Hampterz/novacode/images/IMG_8082.jpg

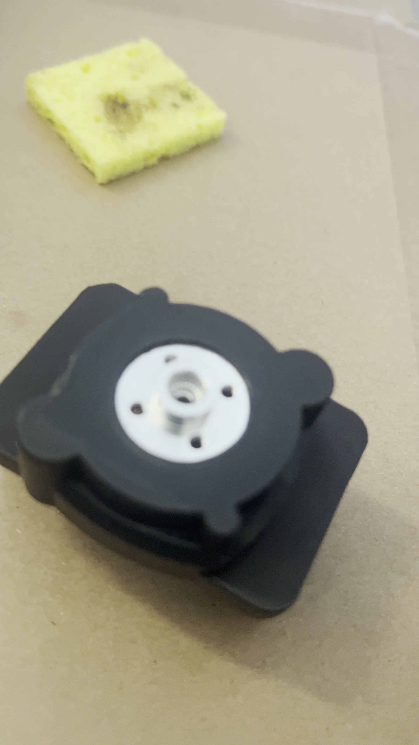
images/IMG_8082.jpg
