Hampterz/novacode/Nova-SM3/STL Files/completed/SM3_Frame_FrontShoulderOuter.stl

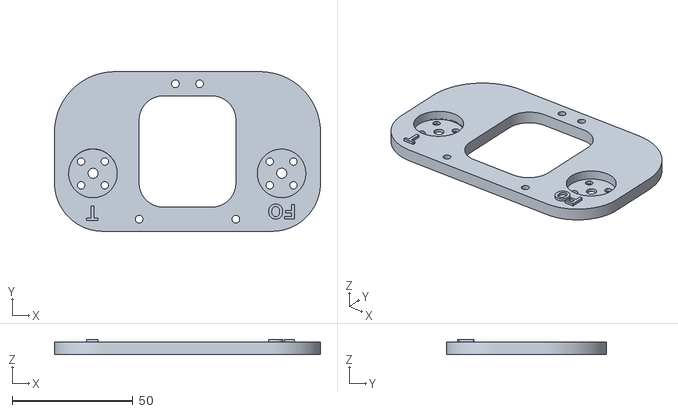
[picture p19: CAD file, 2026-09-12]
Nova-SM3/STL Files/completed/SM3_Frame_FrontShoulderOuter.stl
110.0 x 66.0 x 6.00
