Hampterz/novacode/Nova-SM3/STL Files/completed/SM3_Cover_TopFront.stl

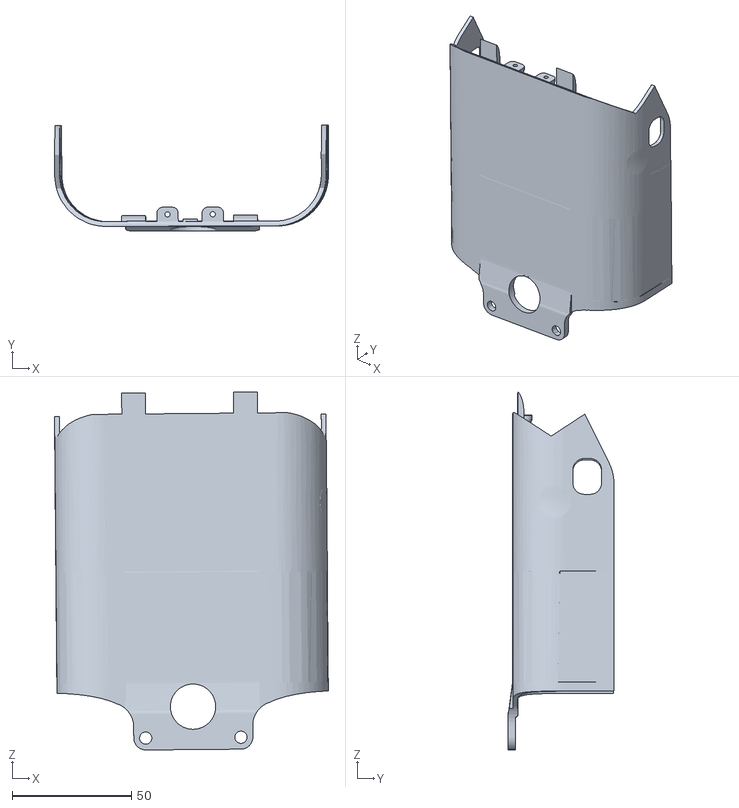
[picture p20: CAD file, 2026-09-12]
Nova-SM3/STL Files/completed/SM3_Cover_TopFront.stl
115.1 x 44.6 x 150.3
