Hampterz/novacode/Nova-SM3/STL Files/completed/SM3_Frame_FrontShoulderMiddle.stl

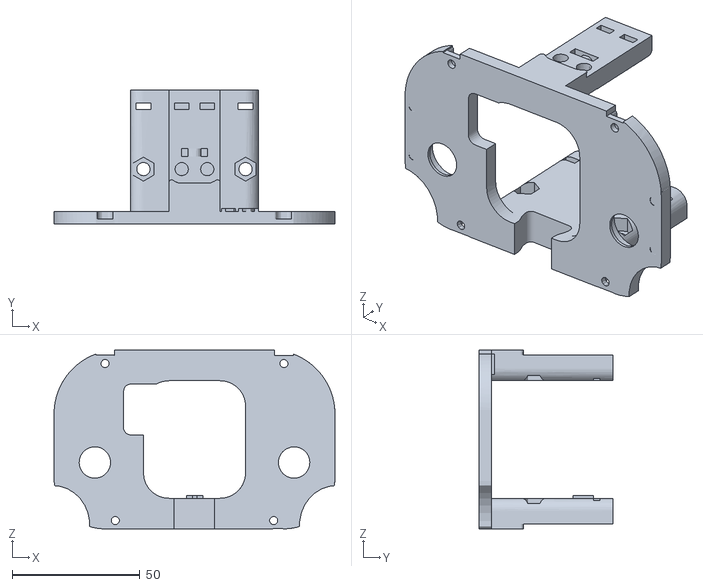
[picture p21: CAD file, 2026-09-12]
Nova-SM3/STL Files/completed/SM3_Frame_FrontShoulderMiddle.stl
110.0 x 52.5 x 70.0
