Hampterz/novacode/Nova-SM3/STL Files/completed/SM3_Cover_BottomRear.stl

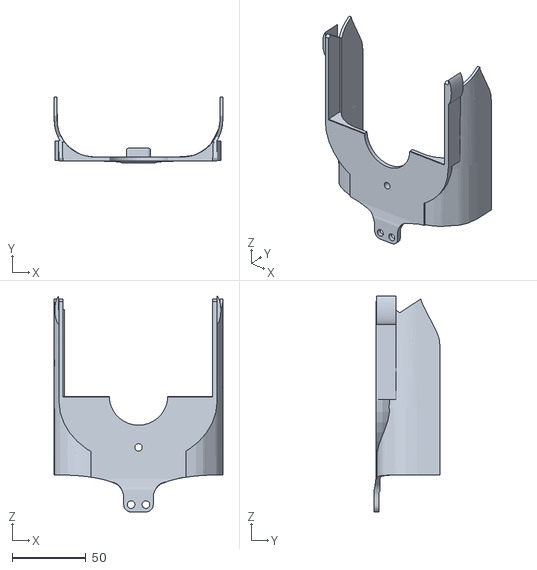
[picture p22: CAD file, 2026-09-12]
Nova-SM3/STL Files/completed/SM3_Cover_BottomRear.stl
114.0 x 44.4 x 146.1
