Hampterz/novacode/Nova-SM3/STL Files/completed/SM3_Cover_RearPanel_2Piece_Shell.stl

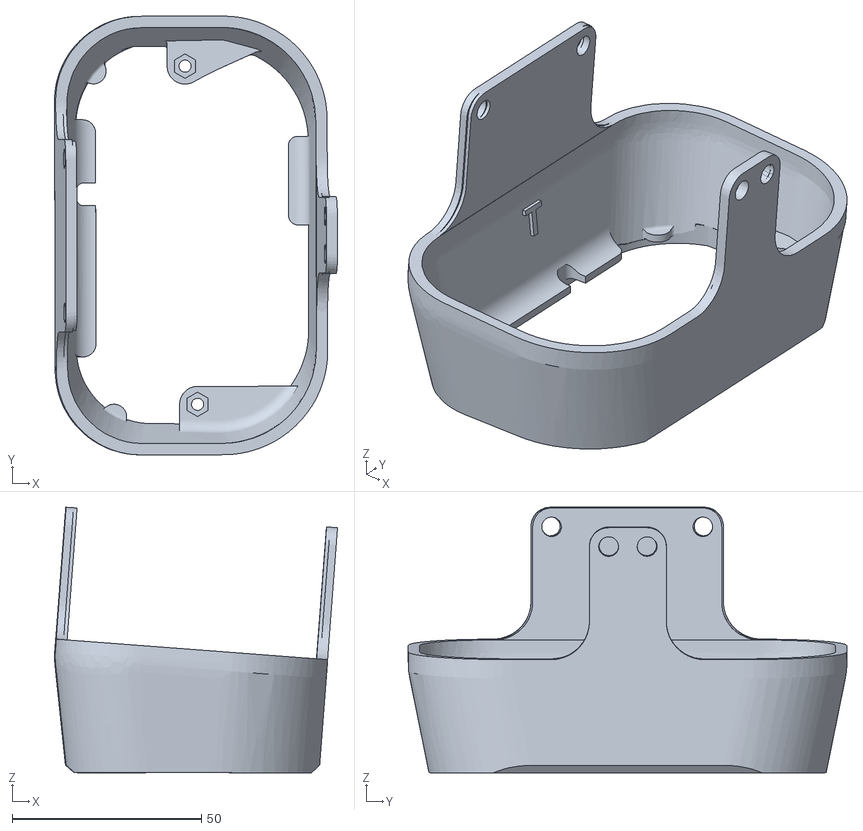
[picture p23: CAD file, 2026-09-12]
Nova-SM3/STL Files/completed/SM3_Cover_RearPanel_2Piece_Shell.stl
74.8 x 116.1 x 70.2
