Hampterz/novacode/Nova-SM3/STL Files/completed/SM3_CalibrationTool.stl

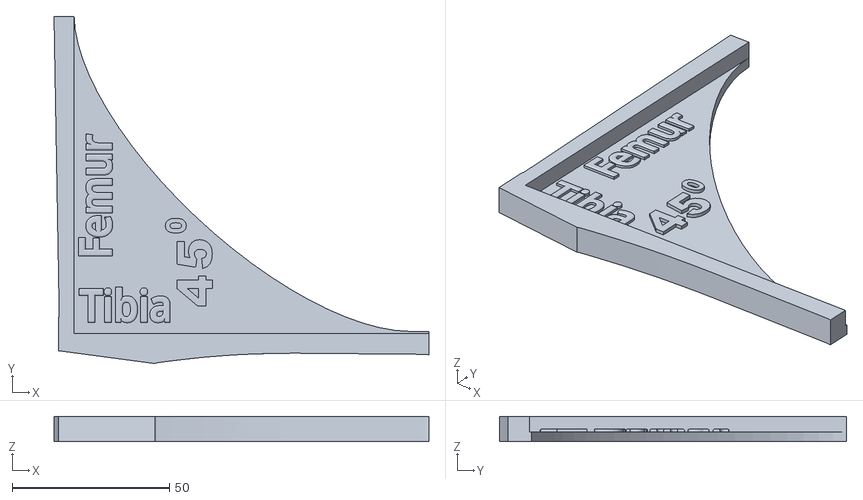
[picture p24: CAD file, 2026-09-12]
Nova-SM3/STL Files/completed/SM3_CalibrationTool.stl
119.4 x 110.6 x 8.00
