Hampterz/novacode/Nova-SM3/STL Files/completed/SM3_Frame_RearShoulderInner.stl

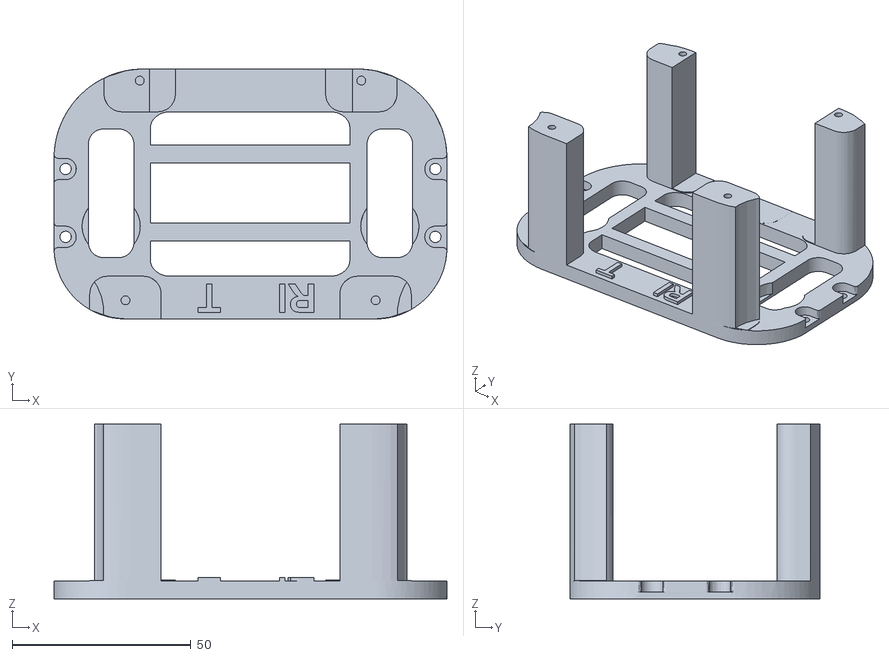
[picture p25: CAD file, 2026-09-12]
Nova-SM3/STL Files/completed/SM3_Frame_RearShoulderInner.stl
110.0 x 70.0 x 49.0
