Hampterz/novacode/Nova-SM3/STL Files/completed/SM3_Cover_RightFemur.stl

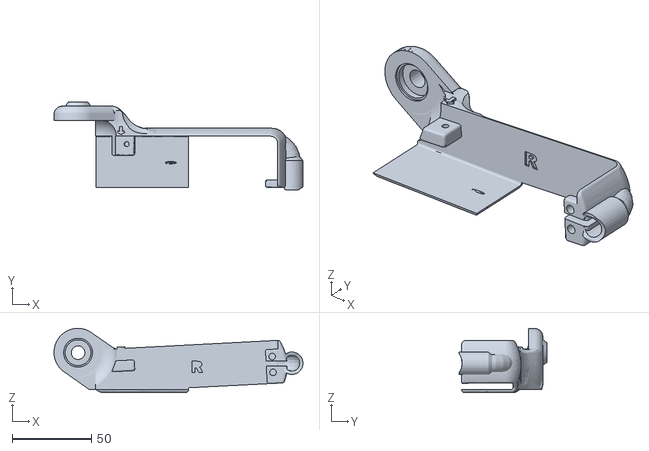
[picture p26: CAD file, 2026-09-12]
Nova-SM3/STL Files/completed/SM3_Cover_RightFemur.stl
156.8 x 55.5 x 40.4
