Hampterz/novacode/Nova-SM3/STL Files/completed/SM3_Foot.stl

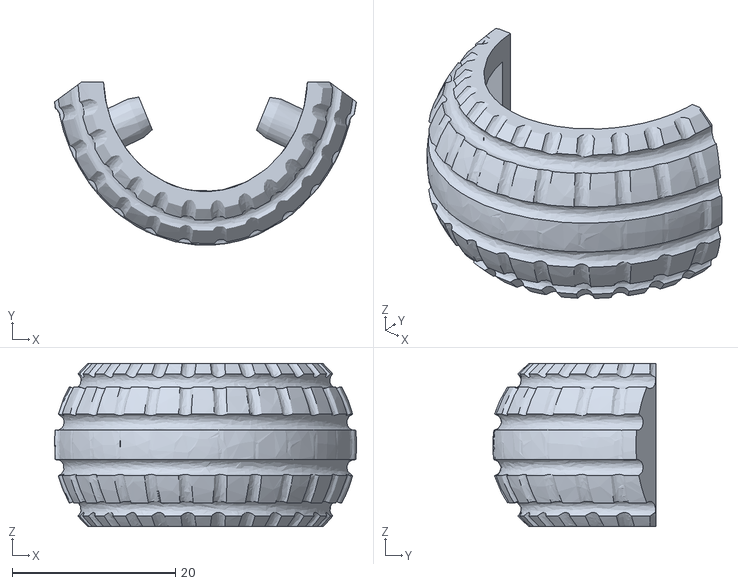
[picture p27: CAD file, 2026-09-12]
Nova-SM3/STL Files/completed/SM3_Foot.stl
37.0 x 20.0 x 20.0
