Hampterz/novacode/Nova-SM3/STL Files/completed/SM3_Frame_ChassisTrunk.stl

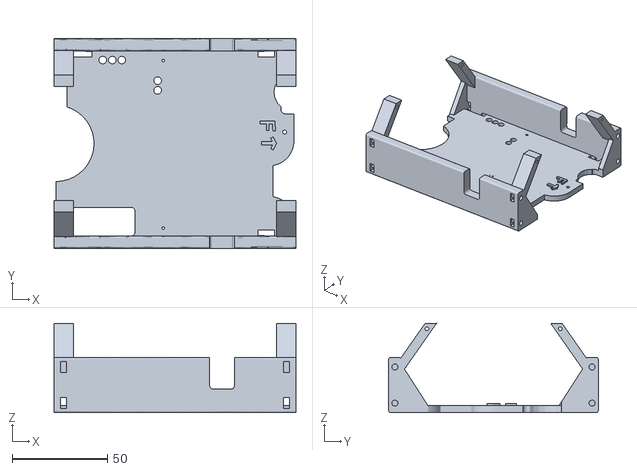
[picture p28: CAD file, 2026-09-12]
Nova-SM3/STL Files/completed/SM3_Frame_ChassisTrunk.stl
127.0 x 110.0 x 46.9
