Hampterz/novacode/Nova-SM3/STL Files/completed/SM3_Cover_BottomHatch.stl

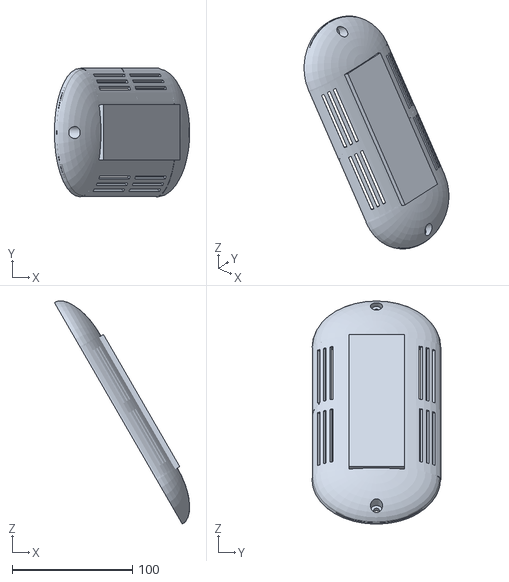
[picture p29: CAD file, 2026-09-12]
Nova-SM3/STL Files/completed/SM3_Cover_BottomHatch.stl
112.5 x 107.4 x 185.6
