Hampterz/novacode/Nova-SM3/STL Files/completed/SM3_Frame_RearShoulderMiddle.stl

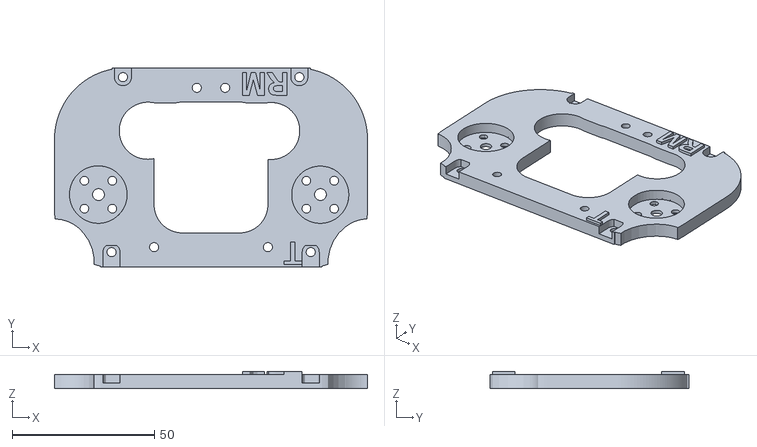
[picture p30: CAD file, 2026-09-12]
Nova-SM3/STL Files/completed/SM3_Frame_RearShoulderMiddle.stl
110.0 x 70.0 x 6.00
