Hampterz/novacode/Nova-SM3/STL Files/completed/SM3_Sensor_FrontPIRMount.stl

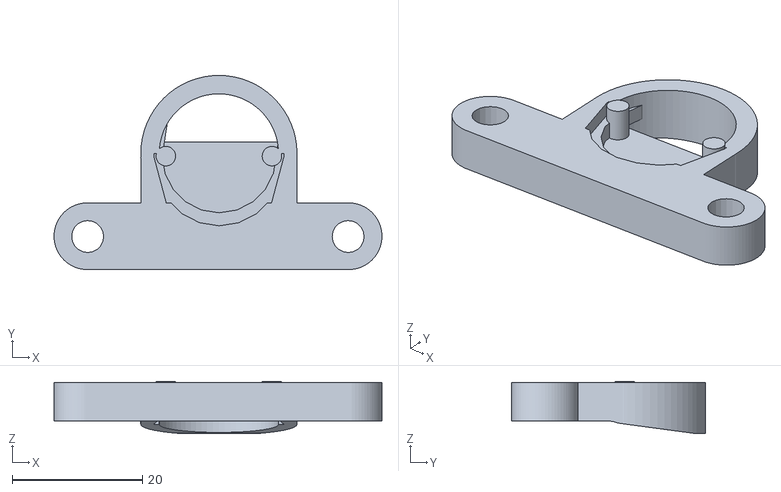
[picture p31: CAD file, 2026-09-12]
Nova-SM3/STL Files/completed/SM3_Sensor_FrontPIRMount.stl
50.4 x 29.8 x 8.05
