Hampterz/novacode/Nova-SM3/STL Files/completed/SM3_Cover_RearPanel_2Piece_Base.stl

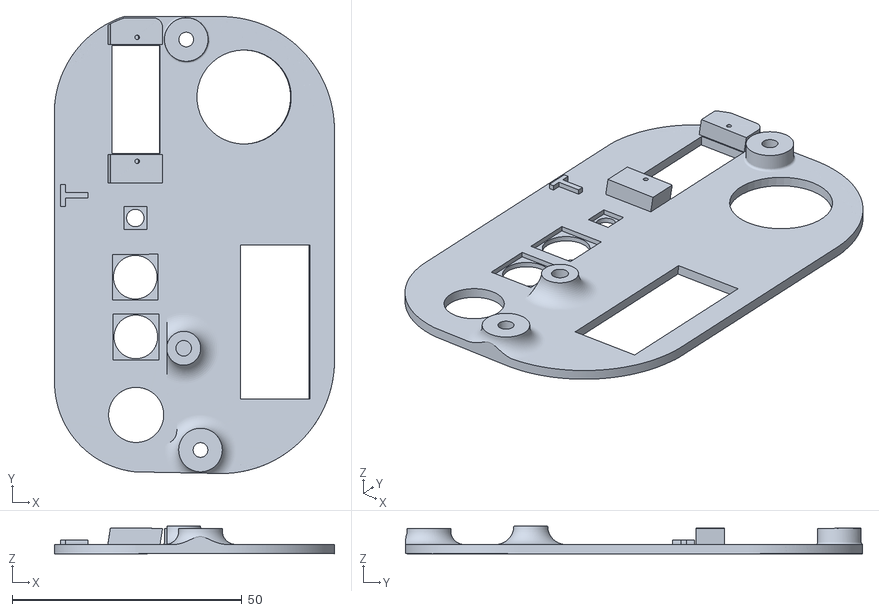
[picture p32: CAD file, 2026-09-12]
Nova-SM3/STL Files/completed/SM3_Cover_RearPanel_2Piece_Base.stl
61.0 x 99.6 x 6.04
