Hampterz/novacode/Nova-SM3/STL Files/completed/SM3_Cover_RearPanelBtnHolder_6x6LongBtn.stl

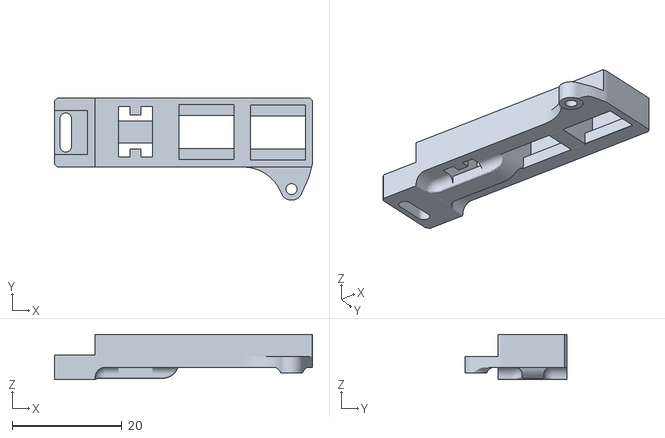
[picture p33: CAD file, 2026-09-12]
Nova-SM3/STL Files/completed/SM3_Cover_RearPanelBtnHolder_6x6LongBtn.stl
46.9 x 18.6 x 8.23
