Hampterz/novacode/Nova-SM3/STL Files/completed/SM3_Cover_TopRear.stl

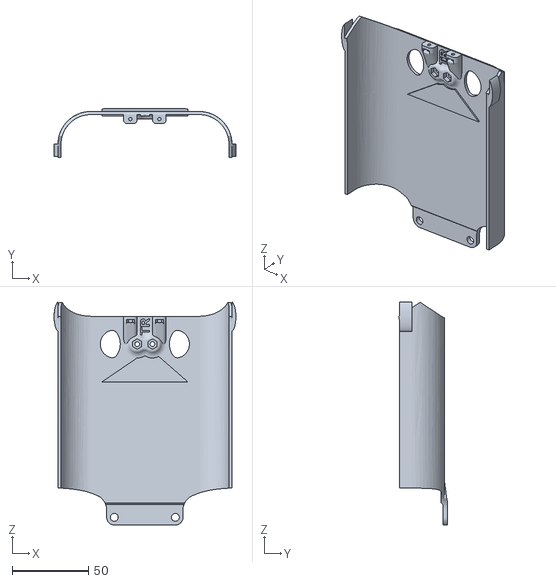
[picture p34: CAD file, 2026-09-12]
Nova-SM3/STL Files/completed/SM3_Cover_TopRear.stl
119.1 x 32.1 x 146.0
