Hampterz/novacode/Nova-SM3/STL Files/completed/SM3_Sensor_RearPIRMount.stl

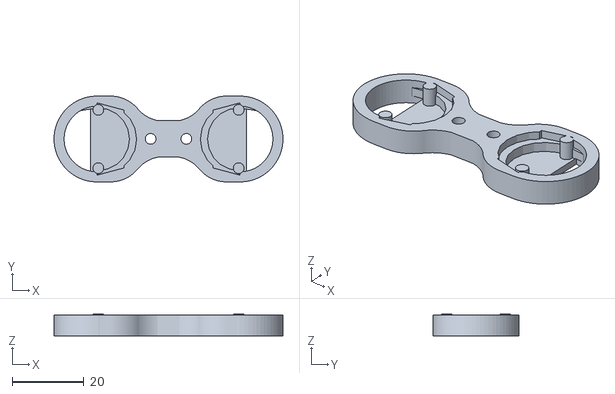
[picture p35: CAD file, 2026-09-12]
Nova-SM3/STL Files/completed/SM3_Sensor_RearPIRMount.stl
64.0 x 24.1 x 6.10
