Hampterz/novacode/Nova-SM3/STL Files/completed/SM3_Frame_LeftCoax.stl

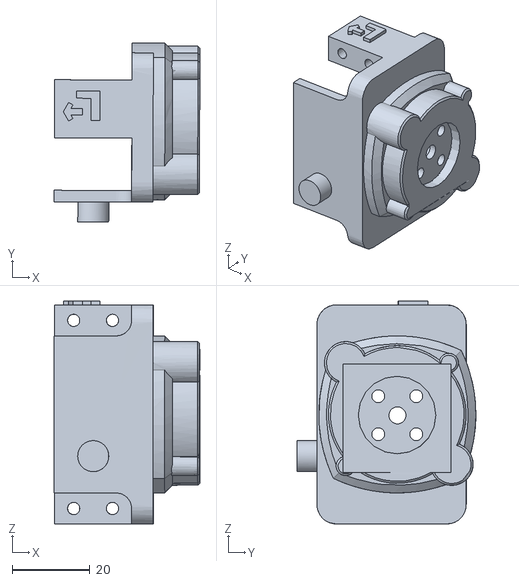
[picture p36: CAD file, 2026-09-12]
Nova-SM3/STL Files/completed/SM3_Frame_LeftCoax.stl
37.6 x 46.1 x 57.5
