Hampterz/novacode/Nova-SM3/STL Files/completed/SM3_Frame_LeftFemur.stl

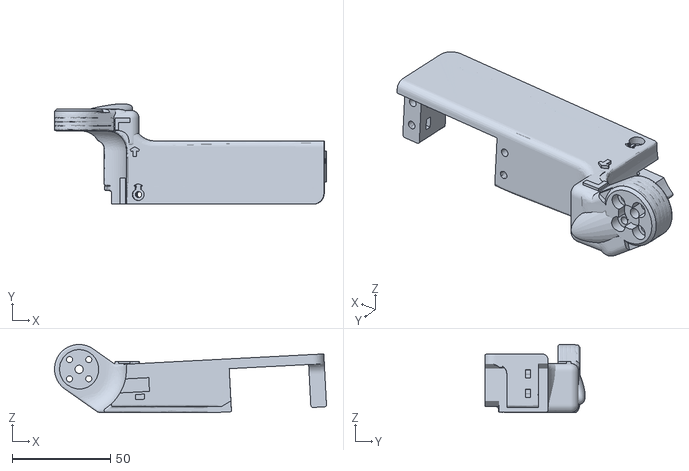
[picture p37: CAD file, 2026-09-12]
Nova-SM3/STL Files/completed/SM3_Frame_LeftFemur.stl
138.5 x 51.1 x 34.7
