Hampterz/novacode/Nova-SM3/STL Files/completed/SM3_Frame_RightTibia.stl

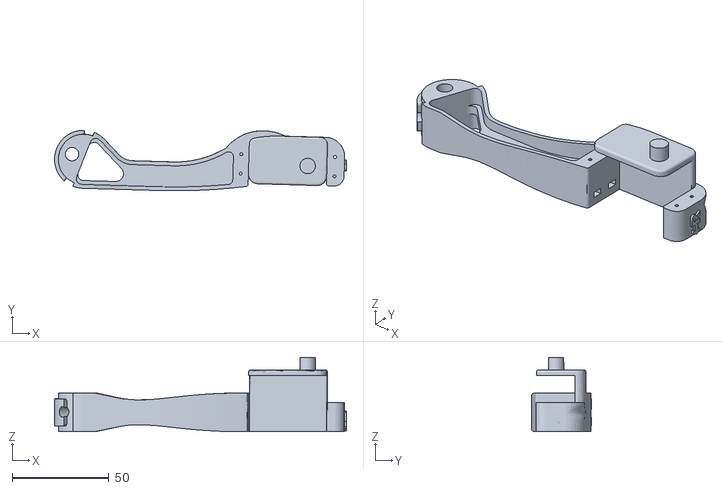
[picture p38: CAD file, 2026-09-12]
Nova-SM3/STL Files/completed/SM3_Frame_RightTibia.stl
151.0 x 31.3 x 38.5
