Hampterz/novacode/Nova-SM3/STL Files/completed/SM3_Cover_HeadPanel.stl

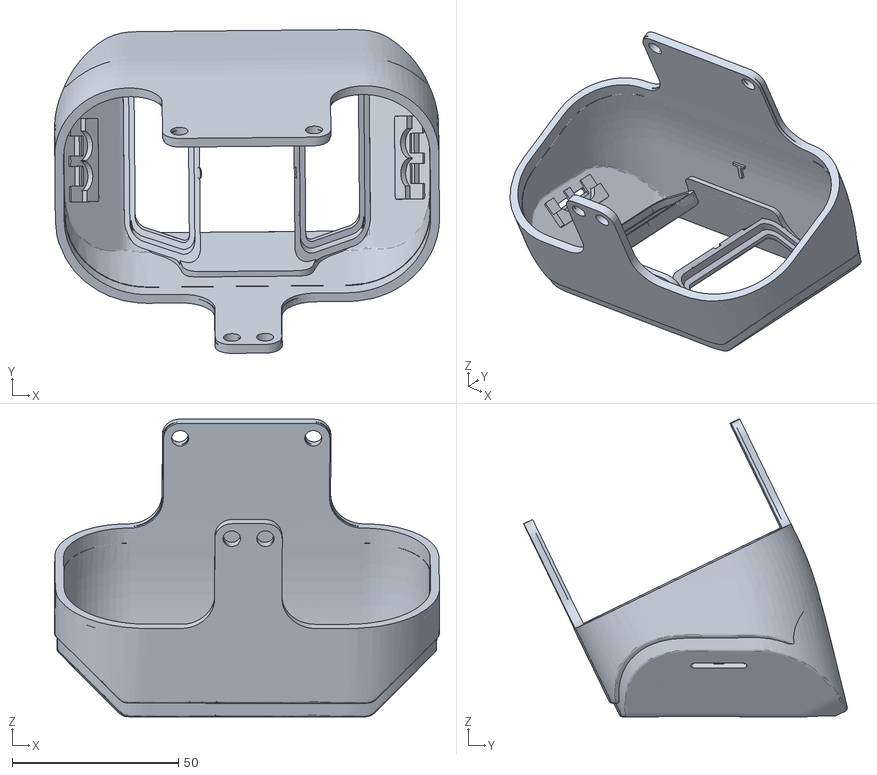
[picture p39: CAD file, 2026-09-12]
Nova-SM3/STL Files/completed/SM3_Cover_HeadPanel.stl
115.7 x 97.3 x 89.5
