Hampterz/novacode/Nova-SM3/STL Files/completed/SM3_Frame_LeftTibia.stl

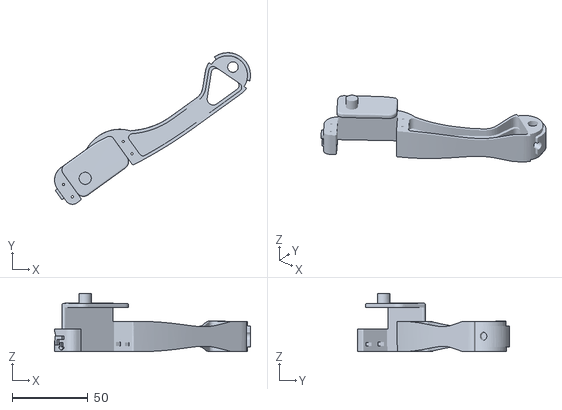
[picture p40: CAD file, 2026-09-12]
Nova-SM3/STL Files/completed/SM3_Frame_LeftTibia.stl
129.3 x 100.1 x 38.5
