Hampterz/novacode/Nova-SM3/STL Files/completed/SM3_Sensor_MP3SpeakerMount.stl

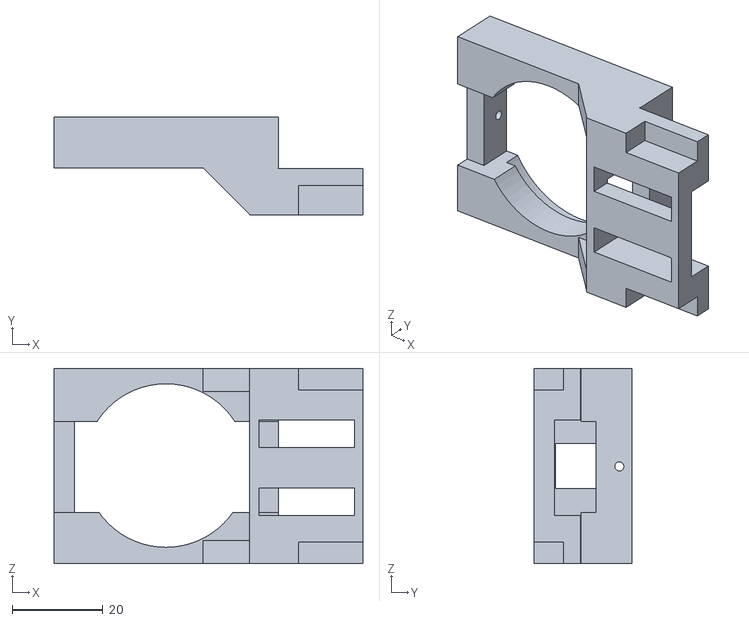
[picture p41: CAD file, 2026-09-12]
Nova-SM3/STL Files/completed/SM3_Sensor_MP3SpeakerMount.stl
68.0 x 21.6 x 43.0
