Hampterz/novacode/Nova-SM3/STL Files/completed/SM3_Cover_BottomFront.stl

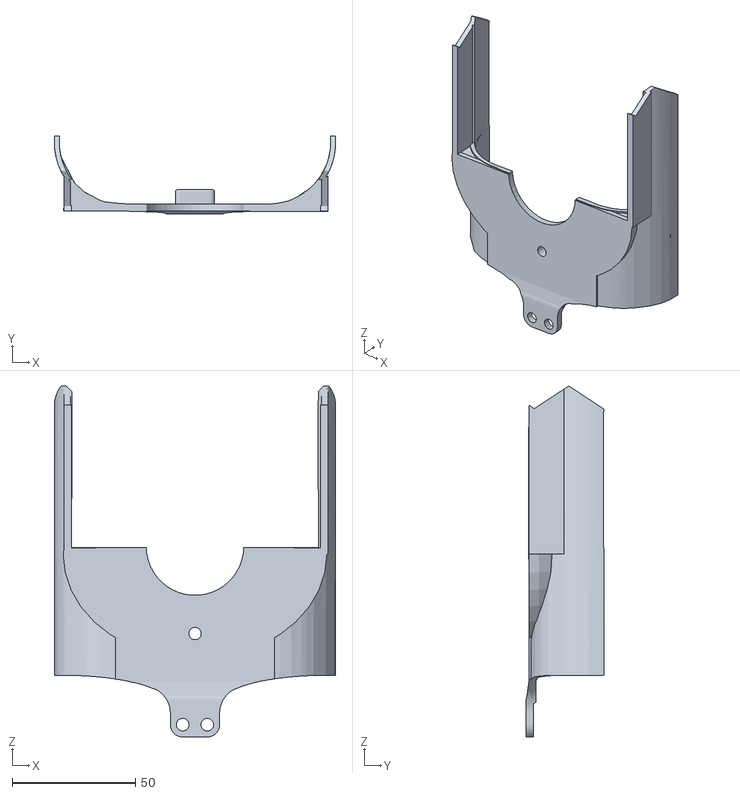
[picture p42: CAD file, 2026-09-12]
Nova-SM3/STL Files/completed/SM3_Cover_BottomFront.stl
114.0 x 31.6 x 142.3
