Hampterz/novacode/Nova-SM3/STL Files/completed/SM3_Sensor_PIRCup.stl

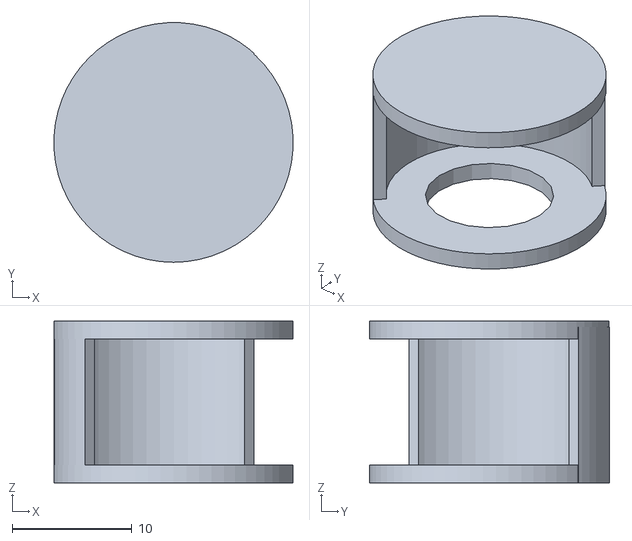
[picture p43: CAD file, 2026-09-12]
Nova-SM3/STL Files/completed/SM3_Sensor_PIRCup.stl
20.0 x 20.0 x 13.5
