Hampterz/novacode/Nova-SM3/STL Files/completed/SM3_Electronics_BuckConveterCase.stl

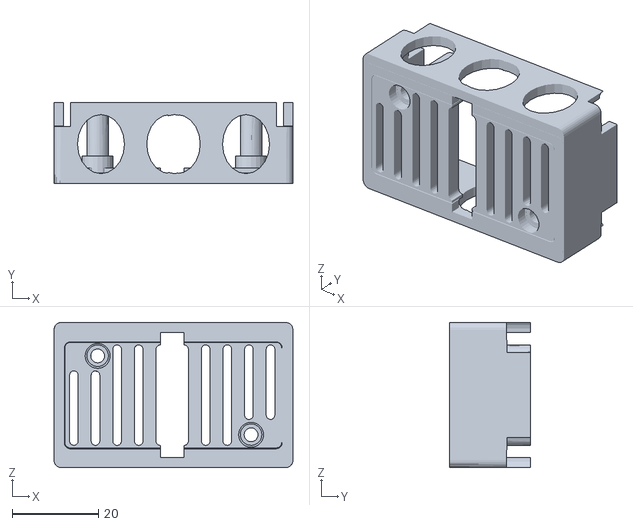
[picture p44: CAD file, 2026-09-12]
Nova-SM3/STL Files/completed/SM3_Electronics_BuckConveterCase.stl
55.3 x 18.8 x 33.6
