Hampterz/novacode/Nova-SM3/STL Files/completed/SM3_Mp3ProSpeakerMount.stl

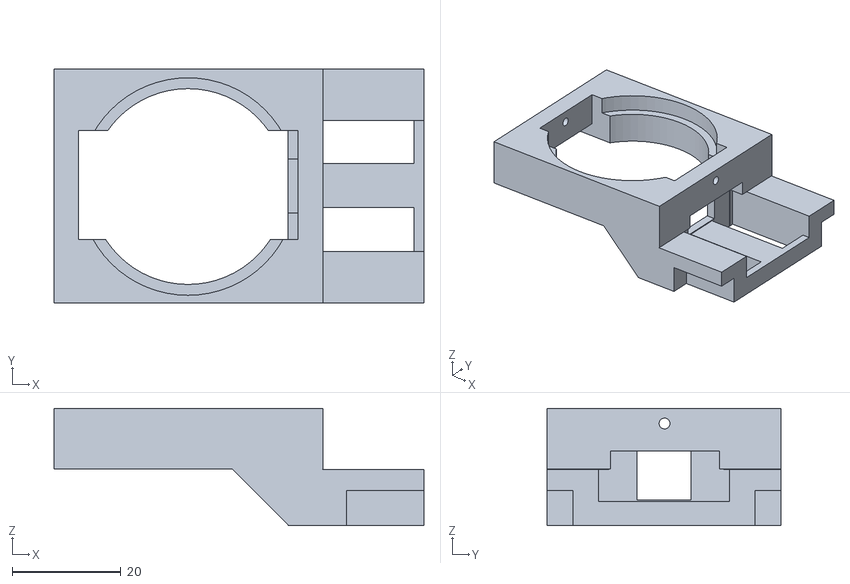
[picture p45: CAD file, 2026-09-12]
Nova-SM3/STL Files/completed/SM3_Mp3ProSpeakerMount.stl
68.0 x 43.0 x 21.6
