Hampterz/novacode/Nova-SM3/STL Files/completed/SM3_Frame_FrontShoulderInner.stl

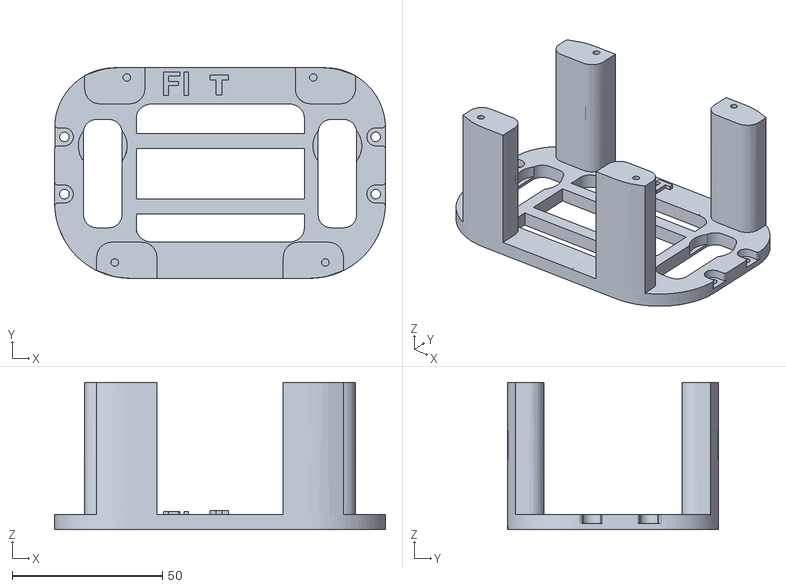
[picture p46: CAD file, 2026-09-12]
Nova-SM3/STL Files/completed/SM3_Frame_FrontShoulderInner.stl
110.0 x 70.0 x 49.0
