Hampterz/novacode/(list of files, cad)

Other CAD files:
Nova-SM3/STL Files/completed/SM3_Cover_LeftFemur.stl
Nova-SM3/STL Files/completed/SM3_Frame_RearShoulderOuter.stl
Nova-SM3/STL Files/completed/SM3_Frame_RightFemur.stl
Nova-SM3/STL Files/completed/SM3_Frame_RightCoax.stl
