Hampterz/novacode/Nova-SM3/Code/Nova-SM3_teensyNRF-v5.2b_mp3_pro/Nova-SM3_teensyNRF-v5.2b_mp3_pro.ino

/*
 * 
 *   NovaSM3 - a Spot-Mini Micro clone
 *   Version: 5.2b
 *   Version Date: 2026-09-13 (turn-in-place semi-success: right turn good, left turn pivots/strains RF; updated home calibration)
 *   
 *   Author:  Chris Locke - cguweb@gmail.com
 *   Nova's website:  https://novaspotmicro.com
 *   GitHub Project:  https://github.com/cguweb-com/Arduino-Projects/tree/main/Nova-SM3
 *   YouTube Playlist:  https://www.youtube.com/watch?v=00PkTcGWPvo&list=PLcOZNHwM_I2a3YZKf8FtUjJneKGXCfduk
 *   
 *   DEBUG NOTE: Teensy will not run if disconnected from serial with any d ebug flag set, as these all
 *               write to serial. Be sure to set all debug flags to 0 before running offline.
 *   
 *   RELEASE NOTES:
 *      Teensy 4.0 performance: 6% storage / 29% memory
 *      Added NRF Module and interface to NovaSMRemote
 *      Removed PS2 setup and interface
 *      Added DFPlayer Mini Pro as second option of MP3 player
 *      Fixed volume pot
 *      Activated code for volume control of MP3 player if enabled
 *      Fixed voltage divider / battery monitor equation
 *      Removed piezo buzzer and TONE support
 *      Added MP3_PLAYER_TYPE setting for DFPlayer Mini and Mini Pro selection
 *
 *
 *   DEV NOTES:
 *      teensy mpu / code is not playing as nicely as with mega - not smooth movement! :(
 *      work on integrating MPU data into movements
 *      adjust sensitivity of PIR (seems 12-24 inches too close)
 *      
 *      BUG: ramping: on interruption of ramp, servo speed is set to the speed of the point of interrupt
 *      
 *      
 *      see more 'DEV NOTE' comments in code for other bugs/tasks
 *      all 'DEV WORK' comments denote code that is currently under development and will be removed upon completion
 *     
 *   =============================================================
 *     
 *   Copyright (c) 2020-2021 Christopher M. Locke and others
 *   Distributed under the terms of the MIT License. 
 *   SPDX-License-Identifier: MIT
 *   
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
 *      
*/

//DEVWORK
int  test_loops = 0;  
int  test_steps = 0;  

//set Nova SM3 version
#define VERSION 5.2

//debug vars for displaying operation runtime data for debugging
const byte debug  = 1;            //general messages
const byte debug1 = 1;            //remote commands and pir sensors
const byte debug2 = 0;            //debug servo steps
const byte debug3 = 0;            //ramping and sequencing
const byte debug4 = 0;            //amperage and battery 
const byte debug5 = 0;            //mpu
const byte debug6 = 0;            //serial communication output/response and serial terminal commands
const byte debug7 = 0;            //uss sensors
const byte debug8 = 0;            //NRF24 comm
const byte plotter = 0;           //plot servo steps, turn off debug1

byte debug_leg = 0;               //default debug leg (3 servos) (changed by serial command input)
int debug_servo = 2;              //default debug servo (changed by serial command input)
int debug_loops = 3;              //default loops for debug movements
int debug_loops2 = 3;             //movement decremented loop
int debug_spd = 10;               //default speed for debug movements

//activate/deactivate devices
byte slave_active = 1;            //activate slave arduino nano (REQUIRED for USS sensors)
byte pwm_active = 1;              //activate pwm controller / servos
byte nrf_active = 1;              //activate NRF24 remote control
byte serial_active = 1;           //activate serial monitor command input
byte mpu_active = 0;              //activate MPU6050 
byte rgb_active = 0;              //activate RGB modules
byte oled_active = 1;             //activate OLED display
byte pir_active = 0;              //activate PIR motion sensor
byte uss_active = 1;              //activate Ultra-Sonic sensors
byte amp_active = 0;              //activate amperate monitoring
byte batt_active = 0;             //activate battery level monitoring
byte buzz_active = 0;             //activate simple tone sounds 
byte melody_active = 0;           //activate melodic tone sounds 
byte mp3_active = 0;              //activate if mp3 player installed
byte splash_active = 0;           //show all loading graphics & sounds
byte quick_boot = 1;              //skip most loading graphics & sounds

#define MP3_PLAYER_TYPE 1         //set to 1 for Mini Pro or to 0 for Mini

//include supporting libraries
#include <Wire.h>
#include <Adafruit_PWMServoDriver.h>
#include <SoftwareSerial.h>
#include <SPI.h>
#include <RF24.h>

//MP3 Setup
//#if MP3_PLAYER_TYPE > 0
  #include <DFRobot_PLAY.h>
  DFRobot_PLAY DFPlayer;
//#else
//  #include <DFRobotDFPlayerMini.h>
//  DFRobotDFPlayerMini DFPlayer;
//#endif


//Teensy 2nd i2c bus and onboard led
#define SDA2_PIN 17
#define SCL2_PIN 16
#define LED_PIN 13

//pwm controller
Adafruit_PWMServoDriver pwm1 = Adafruit_PWMServoDriver(0x40);
#define SERVO_FREQ 60             //CAUTION: do not change this once calibrated to servos!
#define OSCIL_FREQ 25000000       //CAUTION: do not change this once calibrated to servos!
#define OE_PIN 3                  //PWM Output Enable pin
byte pwm_oe = 0;                  //boolean control for enable / disable output
const float min_spd = 32.0;       //min is higher than max, since this is the time increment delay between servo calls 
const float max_spd = 0.0;        //maximum, fastest speed
float default_spd = 2.5;          //fast responsive default speed (was 12.0)
float spd = default_spd;
float spd_prev = default_spd;
float spd_factor = 1.0;           //ratio factor used in movements
const float min_spd_factor = 5.0;
const float max_spd_factor = 0.5;
float spd_c;
float spd_f;
float spd_t;
byte step_start = 0;              //boolean to check if sequenced steps are running
float x_dir = 0;
float y_dir = 0;
float z_dir = 0;
byte use_ramp = 0;                //boolean to enable / disable ramping function
float ramp_dist = 0.20;           //ramp percentage distance from each end of travel (ex: 0.20 ramps up from 0-20% of travel, then ramps down 80-100% of travel)
float ramp_spd = 5.00;            //default ramp speed multiplier

//buzzer
#define BUZZ 22                   //piezo buzzer / speaker module pin

//MP3 DFPlayer 
//track list: 
//  1.saber 2.r2one 3.r2two 4.siren 5.chewy 6.radar 7.mariobro 8.laugh 9.what 10.nova 11.hello
//  12.mode1 13.mode2 14.mode3 15.mode4 16.fon 17.foff 18.sustain 19.warn 20.danger 21.critical 22.halt
//  23.fmodeon 24.fmodeoff 25.click1  
#define MP3_VOL_PIN A9
unsigned int potInterval = 1000;
unsigned long lastPotUpdate = 0;
static const uint8_t PIN_MP3_TX = 1;
static const uint8_t PIN_MP3_RX = 0; 
#define softwareSerial Serial1 // FIX: Teensy 4.0 does not support SoftwareSerial, use hardware Serial1 (pins 0/1)

//mp3 player
unsigned int mp3Interval = 50;
unsigned long lastMP3Update = 0;
int mp3_queue[5] = {0,0,0,0,0};   //DEV: queue of sounds to be played
int mp3_status = 0;               //current playing status
int vpot_max = 350;               //for crappy unreliable pots, set this to your pot's max (-1036)
int vpot_min = 50;                //for crappy unreliable pots, set this to your pot's min (+0)
int vpot_loop = 8;                //for crappy unreliable pots, loop and average value
int vpot_cnt = 0;                 //count of loops for average value
int vpot_avg = 0;                 //total for loop and average value
int vol_max = 25;                 //at mp3 player max of 30, small speakers distort - 25 is suggested
int vol_min = 0;                  //set to 0 to essentially turn off sounds at lowest volume
int sound_vol = 15;               //current volume (1-30)
int sound_volp = 15;              //prev current volume (1-30)
int sounds_req = 25;              //required sound files
int sounds_sd = 0;                //sd card sound files
int sound_cnt = 0;                //loop timer count
int sound_cur = 0;                //current loop timer

//rgb leds
int pattern_int = 250;            //set pattern delay between
int pattern_cnt = 3;              //set number of loops of pattern

//pir sensor
#define PIR_FRONT 4
#define PIR_LEFT 5
#define PIR_RIGHT 6
unsigned int pirInterval = 150;
unsigned long lastPIRUpdate = 0;
unsigned int pirDelay = 3;        //number of interval cycles, not ms
int pir_frontState = LOW;
int pir_leftState = LOW;
int pir_rightState = LOW;
int pir_halt = 1;
byte pir_reset = 0;
int pir_wait = 0;
byte pir_state = LOW;
byte pir_val = 0;
int pir_repeat_cnt = 0;
int pir_is_active = pir_active;
int follow_dir = 0;
int follow_dir_prev = 0;

//ultrasonic sensors (2 - left & right)
unsigned int ussInterval = 250;
unsigned long lastUSSUpdate = 0;
int distance_alarm = 10;              //distance to set triggers
int distance_alarm_set = 0;           //count consecutive set triggers
int distance_tolerance = 5;           //threshold before setting triggers
int distance_l;                       //current distance from left sensor
int prev_distance_l;                  //previous distance of left sensor to prevent false positives
int distance_r;                       //current distance from right sensor
int prev_distance_r;                  //previous distance of right sensor to prevent false positives
int uss_is_active = uss_active;


//mpu6050 sensor
const int MPU = 0x68;
unsigned int mpuInterval = 10;
unsigned int mpuInterval_prev = 400;
unsigned long lastMPUUpdate = 0;
float mroll, mpitch, myaw;
float mroll_prev, mpitch_prev, myaw_prev;
float accAngleX, accAngleY, gyroAngleX, gyroAngleY, gyroAngleZ;
float mpu_mroll = 0.00;
float mpu_mpitch = 0.00;
float mpu_myaw = 0.00;
float mpu_trigger_thresh = 0.05;
float elapsedTime;
unsigned long currentTime, previousTime;
int mpu_is_active = mpu_active;
int mpu_c = 0;

//NovaSMRemote NRF24 controller
//Pin wiring for Teensy 4.0:
//  pin 9 -> CE pin
//  pin 10 -> CSN pin
//  pin 13 -> SCK pin
//  pin 11 -> MOSI pin
//  pin 12 -> MISO pin
//  pin xx -> IRQ pin (unused)
// instantiate an object for the nRF24L01 transceiver
RF24 nrf_radio(9, 10);
unsigned int nrfInterval = 50;
unsigned long lastNRFUpdate = 0;
unsigned int remoteInterval = 50;
unsigned long lastRemoteUpdate = 0;

uint8_t address[][6] = {"1Node", "2Node"};
bool radioNumber = 1; // 0 uses address[0] to transmit, 1 uses address[1] to transmit
const int data_num = 14;          //bytes of data to receive
bool rc_resp;
uint8_t rc_data[data_num] = {     //receive data array
  0, 0, 0, 0,                     //btn1, btn2, btn3, btn4
  0, 0,                           //sel1, sel2
  0, 0, 0, 0,                     //p1, p2, p3, p4
  0, 0, 0, 0                      //lx, ly, rx, ry
};
uint8_t tm_data[data_num] = {     //transmit data array
  0, 0, 0,                        //battery, spd, volume
  0, 0, 0,                        //move_steps, step_weight_factor_front, step_weight_factor_rear
  1, 0, 0, 0,                     //remote_select, start_mode
  0, 0, 0, 0                      //
};
//init remote control vars
uint8_t btn1 = 0, btn2 = 0, btn3 = 0, btn4 = 0;
uint8_t btn1p = 0, btn2p = 0, btn3p = 0, btn4p = 0;
uint8_t sel1 = 0, sel2 = 0; 
uint8_t sel1p = 0, sel2p = 0; 
int pot_threshold = 5;
uint8_t p1t = pot_threshold, p2t = pot_threshold, p3t = pot_threshold, p4t = pot_threshold; 
uint8_t p1 = 0, p2 = 0, p3 = 0, p4 = 0; 
uint8_t p1p = 0, p2p = 0, p3p = 0, p4p = 0; 
uint8_t lx = 0, ly = 0, rx = 0, ry = 0; 
uint8_t lxp = 0, lyp = 0, rxp = 0, ryp = 0; 
int pot_min = 0;                     //if pots are orientated opposing to this configuration, 
int pot_max = 255;                   //swap these two values where min would be max value, and vice-versa
int remote_start_stop = 0;           //tracks remote start/stop mode
int remote_select = 1;               //sets default button set
byte start_mode = 0;                 //current start mode
int spd_lock = 0;                    //switch to hold prev spd and allow code to control spd, and not input device(s)
int step_lock = 0;                   //switch to hold prev steps and allow code to control move_steps, and not input device(s)


//slave arduino and serial commands
#define SLAVE_ID 1
byte serial_oled = 0;            //switch for serial or oled commands
int serial_resp;
int ByteReceived;
unsigned int serialInterval = 60;
unsigned long lastSerialUpdate = 0;
String serial_input;


//amperage monitor
#define AMP_PIN A1
#define PWR_PIN 2
unsigned int ampInterval = 15000;
unsigned long lastAmpUpdate = 0;
int amp_cnt = 0;
int amp_thresh = 10;            //loop count for consecutive amperage alarms to prevent false positives
int amp_warning = 0;            //current alarm warning level
int amp_loop = 1;               //if warning level set, this changes accordingly to prevent false positives
float amp_limit = 6.5;          //aperage draw limit before triggering alarms


//battery monitor
#define BATT_MONITOR A1
unsigned long batteryInterval = 30000;
unsigned long lastBatteryUpdate = 0;
int batt_cnt = 0;
float batt_voltage = 11.8;                          //approx fully charged battery minimum nominal voltage
float batt_voltage_prev = 11.8;                     //comparison voltage to prevent false positives
float avg_volts = 0;
float batt_levels[10] = {                           //voltage drop alarm levels(10)
   11.2, 11.1, 11.0, 10.9, 10.8, 
   10.7, 10.6, 10.5, 10.4, 10.3,
};


//movement vars for steps, delays, loops, sequencing, etc
unsigned long lastMoveDelayUpdate = millis();
unsigned int moveDelayInterval = 0;
int move_delays[16] = {0,0,0,0,0,0,0,0,0,0,0,0,0,0,0,0};
int move_delay_sequences[16] = {0,0,0,0,0,0,0,0,0,0,0,0,0,0,0,0};
int move_delay = 0;
int move_loops = 0;
int move_switch = 0;
float move_steps_min = -100;
float move_steps_max = 100;
float move_steps = 30;
float move_steps_prev = 0;
float move_steps_x = 0;
float move_steps_y = 0;
float move_steps_yaw_x = 0;
float move_steps_yaw_y = 0;
float move_steps_yaw = 0;
float move_steps_kx = 0;
float move_steps_ky = 0;
float move_steps_alt = 0;
int move_c_steps[2] = {-50, 50};
int move_f_steps[2] = {-165, 165};
int move_t_steps[2] = {-120, 120};
int move_x_steps[2] = {-50, 50};
int move_y_steps[2] = {-180, 130};
int move_z_steps[2] = {-50, 50};
float x_dir_steps[2] = {-22, 22};
float y_dir_steps[2] = {-22, 22};
float z_dir_steps[2] = {-40, 40};


//booleans to control / monitor movement routine execution
byte moving = 0;
byte move_y_axis = 0;
byte move_x_axis = 0;
byte move_roll = 0;
byte move_roll_body = 0;
byte move_pitch = 0;
byte move_pitch_body = 0;
byte move_trot = 0;
byte move_forward = 0;
byte move_backward = 0;
byte activeGaitPair = 0;
byte move_left = 0;
byte move_right = 0;
byte move_march = 0;
byte move_wake = 0;
byte move_sequence = 0;
byte move_demo = 0;
byte move_wman = 0;
byte move_funplay = 0;
byte move_look_left = 0;
byte move_look_right = 0;
byte move_roll_x = 0;
byte move_pitch_y = 0;
byte move_kin_x = 0;
byte move_kin_y = 0;
byte move_yaw_x = 0;
byte move_yaw_y = 0;
byte move_yaw = 0;
byte move_servo = 0;
byte move_leg = 0;
byte move_follow = 0;
String move_paused = "";

// Function prototypes
void step_left_right(int lorr, int xdir, int ydir, int zdir = 0);
void fast_home_carpet();

//vars used to compensate for center of gravity / momentum / inertia
float step_weight_factor_front = 1.00;
float step_weight_factor_rear = 1.00;
float step_height_factor = 1.25;    //DEV: not used yet


/*
   -------------------------------------------------------
   Function Prototypes
    :required for functions executed from servo class ( I know, I know, poor OOP design calling functions outside of a class ;p )
   -------------------------------------------------------
*/
void set_ramp(int servo, float sp, float r1_spd, float r1_dist, float r2_spd, float r2_dist);
void amperage_check(int aloop);
void powering_down(void);

//include local class / config files
#include <EEPROM.h>
#include "MPU6050_conf.h"
#include "NovaServos.h"           //include motor setup vars and data arrays
#include "AsyncServo.h"           //include motor class


//instantiate servo objects (s_XXX) with driver reference and servo ID
//coax servo objects
AsyncServo s_RFC(&pwm1, RFC);
AsyncServo s_LFC(&pwm1, LFC);
AsyncServo s_RRC(&pwm1, RRC);
AsyncServo s_LRC(&pwm1, LRC);

//femur servo objects
AsyncServo s_RFF(&pwm1, RFF);
AsyncServo s_LFF(&pwm1, LFF);
AsyncServo s_RRF(&pwm1, RRF);
AsyncServo s_LRF(&pwm1, LRF);

//tibia servo objects
AsyncServo s_RFT(&pwm1, RFT);
AsyncServo s_LFT(&pwm1, LFT);
AsyncServo s_RRT(&pwm1, RRT);
AsyncServo s_LRT(&pwm1, LRT);


void setup() {
  //disable servo outputs immediately to prevent twitching during boot
  pinMode(OE_PIN, OUTPUT);
  digitalWrite(OE_PIN, HIGH);  // HIGH = outputs disabled on PCA9685

  //setup onboard LED
  pinMode(LED_PIN, OUTPUT);
  for (int b = 0; b < 3; b++) {
    digitalWrite(LED_PIN, HIGH);
    delay(150);
    digitalWrite(LED_PIN, LOW);
    delay(150);
  }

  //seed arduino pin A0, otherwise random() functions will not be truely random
  randomSeed(analogRead(0));

  if (debug) {
    Serial.begin(19200);

    //allow serial to connect (wait up to 2 seconds max)
    while (!Serial && millis() < 2000) delay(10);
    Serial.println("hi teensy working");
    delay(500);
    Serial.println(F("\n=============================================="));
    Serial.print(F("NOVA SM3 v"));
    Serial.println(VERSION);
    Serial.println(F("=============================================="));
  }

  //setup 2nd i2c bus
  Wire1.begin();
  Wire1.setTimeout(10); // Prevent I2C from hanging forever if slave disconnects
  Wire1.setSDA(SDA2_PIN);
  Wire1.setSCL(SCL2_PIN);

  if (mp3_active) {
//    #if MP3_PLAYER_TYPE > 0
      softwareSerial.begin(115200);
//    #else
//      softwareSerial.begin(9600);
//    #endif

    if (DFPlayer.begin(softwareSerial)) {
      pinMode(MP3_VOL_PIN, INPUT);
      mp3_volume(sound_vol);

//      #if MP3_PLAYER_TYPE > 0
        DFPlayer.setPlayMode(DFPlayer.SINGLE);
        DFPlayer.setPrompt(false);
        DFPlayer.switchFunction(DFPlayer.MUSIC);
        sounds_sd = DFPlayer.getTotalFile();
//      #else
//        DFPlayer.EQ(DFPLAYER_EQ_ROCK);
//        sounds_sd = DFPlayer.readFileCounts();  
//      #endif
    } else if (debug) {
      Serial.println("Connecting to DFPlayer Mini Pro failed!");
    }
  }

  if (melody_active) {
    if (mp3_active) {
      mp3_volume(16);
      mp3_play(10);
      delay(1500);
      mp3_volume(sound_vol);
      if (rgb_active) {
        rgb_request((char*)"GAk");
      }
      mp3_play(1);
      delay(3000);
      if (!quick_boot) {
        mp3_play(2);
        if (!debug) {
          delay(5000);
        }
      }
    }
  } else if (buzz_active) {
    if (mp3_active) {
      mp3_play(1);
      if (!debug && !quick_boot) {
        delay(3000);
      }
    }
  }

  //show active settings, including delays to prevent IDE reset firing setup functions on upload/connect
  if (debug && !quick_boot) {
    Serial.println(F("Active Settings:"));
    if (slave_active) Serial.println(F("  Slave Circuit"));
    digitalWrite(LED_PIN, HIGH);
    delay(500);
    if (pwm_active) Serial.println(F("  PWM Controller"));
    digitalWrite(LED_PIN, LOW);
    delay(500);
    if (nrf_active) Serial.println(F("  NRF24 Wireless"));
    digitalWrite(LED_PIN, HIGH);
    delay(500);
    if (serial_active) Serial.println(F("  Serial Commands"));
    digitalWrite(LED_PIN, LOW);
    delay(500);
    if (mpu_active) Serial.println(F("  MPU6050 IMU"));
    digitalWrite(LED_PIN, HIGH);
    delay(500);
    if (rgb_active) Serial.println(F("  RGB LEDs"));
    digitalWrite(LED_PIN, LOW);
    delay(500);
    if (oled_active) Serial.println(F("  OLED Display"));
    digitalWrite(LED_PIN, HIGH);
    delay(500);
    if (pir_active) Serial.println(F("  PIR Sensors"));
    digitalWrite(LED_PIN, LOW);
    delay(500);
    if (uss_active) Serial.println(F("  Ultra-Sonic Sensors"));
    digitalWrite(LED_PIN, HIGH);
    delay(250);
    digitalWrite(LED_PIN, LOW);
    delay(250);
    if (amp_active) Serial.println(F("  ACS712 Current Sensor"));
    digitalWrite(LED_PIN, HIGH);
    delay(250);
    digitalWrite(LED_PIN, LOW);
    delay(250);
    if (batt_active) Serial.println(F("  Battery Monitor"));
    digitalWrite(LED_PIN, HIGH);
    delay(250);
    digitalWrite(LED_PIN, LOW);
    delay(250);
    if (buzz_active) Serial.println(F("  Buzzer"));
    digitalWrite(LED_PIN, HIGH);
    delay(250);
    digitalWrite(LED_PIN, LOW);
    delay(250);
    if (melody_active) Serial.println(F("  Melody"));
    digitalWrite(LED_PIN, HIGH);
    delay(250);
    digitalWrite(LED_PIN, LOW);
    delay(250);
    if (mp3_active) {
      Serial.print(F("  MP3 Player: found "));
      Serial.print(sounds_sd);Serial.print(F(" of "));
      Serial.print(sounds_req);Serial.println(F(" sounds required on disk"));
    }
    digitalWrite(LED_PIN, HIGH);
    delay(250);
    digitalWrite(LED_PIN, LOW);
    delay(250);
    if (!splash_active) Serial.println(F("  Skip Splash Screen"));
    digitalWrite(LED_PIN, HIGH);
    delay(250);
    digitalWrite(LED_PIN, LOW);
    delay(250);
    Serial.println(F("\n==============================================\n"));
  } else {
    if (!quick_boot) {
      for (int b = 0; b < 4; b++) {
        digitalWrite(LED_PIN, HIGH);
        delay(500);
        digitalWrite(LED_PIN, LOW);
        delay(500);
      }
      for (int b = 0; b < 6; b++) {
        digitalWrite(LED_PIN, HIGH);
        delay(250);
        digitalWrite(LED_PIN, LOW);
        delay(250);
      }
    }
  }
  

  if (mp3_active && debug && !quick_boot) {
    Serial.print(F("MP3 Player intializing..."));
    delay(500);
    Serial.println(F("\t\t\tOK"));
  }




  //init pir sensors
  if (pir_active) {
    pinMode(PIR_FRONT, INPUT);
    digitalWrite(PIR_FRONT, HIGH); 
   
    pinMode(PIR_LEFT, INPUT);
    digitalWrite(PIR_LEFT, HIGH); 
  
    pinMode(PIR_RIGHT, INPUT);
    digitalWrite(PIR_RIGHT, HIGH); 
  }

  //init amp power control
  if (amp_active) {
    pinMode(PWR_PIN, OUTPUT);
    digitalWrite(PWR_PIN, LOW);
  }


  if (rgb_active) {
    rgb_request((char*)"MUNUEAn");
  }

  if (oled_active) {
    oled_request((char*)"o");
  }
  if (!quick_boot) {
    if (buzz_active || mp3_active) {
      if (mp3_active) {
        mp3_play(4);
        delay(3000);
        if (!splash_active) {
          delay(2000);
        }
      }
      digitalWrite(LED_PIN, LOW);
    } else {
      for (int b = 3; b > 0; b--) {
        digitalWrite(LED_PIN, HIGH);
        delay(250);
        digitalWrite(LED_PIN, LOW);
        delay(250);
      }
    }
  }

  //(re)boot slave nano
  if (slave_active) {
    if (splash_active && !quick_boot) {
      command_slave((char*)"Z");
    } else {
      command_slave((char*)"Y");
    }
  }

  //init NRF24 wireless
  if (nrf_active) {
    if (!nrf_radio.begin()) {
      if (debug8) Serial.println(F("radio hardware is not responding!!"));
      while (1) {}
    } else {
      nrf_radio.setPALevel(RF24_PA_LOW);
      nrf_radio.setPayloadSize(sizeof(rc_data));
      nrf_radio.setChannel(124);
      nrf_radio.openReadingPipe(1, address[!radioNumber]);
      nrf_radio.enableAckPayload();
      nrf_radio.startListening();
      nrf_radio.writeAckPayload(1, &tm_data, sizeof(tm_data)); // pre-load data
      if (debug8) Serial.println(F("radio hardware is ready and listening!"));
    }
  }
  
  //init pwm controller
  if (pwm_active) {
    if (oled_active) {
      oled_request((char*)"o");
    }

    if (debug) Serial.print(F("PWM Controller intializing..."));
    pwm1.begin();
    pwm1.setOscillatorFrequency(OSCIL_FREQ);
    pwm1.setPWMFreq(SERVO_FREQ);

    delay(500);
    if (!splash_active) {
      delay(3000);
    }

    if (debug) Serial.println(F("\t\t\tOK"));
    if (debug) {
      Serial.print(TOTAL_SERVOS); Serial.print(F(" Servos intializing..."));
    }

    //set default speed factor
    spd_factor = mapfloat(spd, min_spd, max_spd, min_spd_factor, max_spd_factor);

    //enable servo outputs before homing so staged PWM pulses reach the servos
    digitalWrite(OE_PIN, LOW);
    delay(50);

    //initialize servos and populate related data arrays with defaults
    init_home();
    delay(500);
    if (debug) Serial.println(F("\t\t\tOK"));

  if (melody_active) {
    if (mp3_active) {
      if (!quick_boot) {
        for (int s=0;s<15;s++) {
          mp3_volume((sound_vol-s));
          delay(250);
        }
        DFPlayer.pause();
        delay(200);
        if (oled_active) {
          oled_request((char*)"y");
        }
        mp3_volume(16);
        delay(50);
        mp3_play(11);
        if (rgb_active) {
          rgb_request((char*)"Id");
        }
        delay(5000);
        if (rgb_active) {
          rgb_request((char*)"Hi");
        }
        delay(1000);
        if (oled_active) {
          oled_request((char*)"n");
        }
        delay(3000);
      }
      mp3_play(7);
    }
  } else if (buzz_active) {
    if (mp3_active) {
      mp3_play(7);
    }
  }

  if (mp3_active) {
    mp3_volume(sound_vol);
  }
  if (rgb_active) {
    rgb_request((char*)"xEi");
    delay(1000);
  }

  //now enable servo outputs - everything is initialized, positions are loaded
  digitalWrite(OE_PIN, LOW);  // LOW = outputs enabled
  delay(1000);  // give servos time to smoothly reach home positions

  //init mpu6050 on Wire1 (pins 16=SCL1, 17=SDA1)
  Wire1.begin();
  Wire1.setTimeout(10); // Prevent I2C from hanging forever if slave disconnects
  delay(100);

  uint8_t c = readByte(MPU6050_ADDRESS, WHO_AM_I_MPU6050);  // Read WHO_AM_I register for MPU-6050
  if (c == 0x68) {  
    if (debug) Serial.println(F("MPU6050 IMU detected on 0x68. Initializing..."));
    calibrateMPU6050(gyroBias, accelBias); // Calibrate gyro and accelerometers, load biases in bias registers  
    initMPU6050();                         // Wake device from sleep, set sample rate and DLPF
    mpu_is_active = 1;
    if (debug) Serial.println(F("MPU6050 IMU initialized OK"));
  } else {
    mpu_is_active = 0;
    if (debug) {
      Serial.print(F("MPU6050 not detected on Wire1 (WHO_AM_I returned 0x"));
      Serial.print(c, HEX);
      Serial.println(F(")"));
    }
  }
  }

  if (!mpu_active) {
    if (debug) {
      Serial.println(F("\nNova SM3... \t\t\t\tReady!"));
      Serial.println(F("=============================================="));
      if (!plotter && serial_active) {
        Serial.println();
        Serial.println(F("Type a command input or 'h' for help:"));
      }
    }
  }

  if (rgb_active) {
    rgb_request((char*)"xKg");
  }
  if (oled_active) {
    oled_request((char*)"l");
  }
  if (!quick_boot) {
    delay(1000);
  }
  
  // Sync the MPU timer so the first loop doesn't have a massive elapsedTime spike
  currentTime = millis();
}



void loop() {
  update_servos();

/*
   -------------------------------------------------------
   Check for Moves
    :check if any scripted, sequenced, or dynamic moves are active
    :and execute accordingly along with any required variables defined
   -------------------------------------------------------
*/
  if (move_sequence) {
    run_sequence();
  } else if (move_x_axis) {
    x_axis();
  } else if (move_y_axis) {
    y_axis();
  } else if (move_pitch_body) {
    pitch_body();
  } else if (move_pitch) {
    pitch(x_dir);
  } else if (move_roll_body) {
    roll_body();
  } else if (move_roll) {
    roll();
  } else if (move_trot) {
    step_trot(x_dir, y_dir, z_dir);
  } else if (move_forward) {
    step_forward(y_dir, x_dir, z_dir);
  } else if (move_backward) {
    step_backward(y_dir, x_dir, z_dir);
  } else if (move_left) {
    step_left_right(1, x_dir, y_dir, z_dir);
  } else if (move_right) {
    step_left_right(0, x_dir, y_dir, z_dir);
  } else if (move_march) {
    step_march(x_dir, y_dir, z_dir);
  } else if (move_wake) {
    wake();
  } else if (move_wman) {
    ramp_dist = 0.2;
    ramp_spd = 0.5;
    use_ramp = 1;
    wman();
  } else if (move_funplay) {
    funplay();
  } else if (move_look_left) {
    look_left();
  } else if (move_look_right) {
    look_right();
  } else if (move_roll_x) {
    roll_x();
  } else if (move_pitch_y) {
    pitch_y();
  } else if (move_kin_x) {
    move_kx();
  } else if (move_kin_y) {
    move_ky();
  } else if (move_yaw_x) {
    yaw_x();
  } else if (move_yaw_y) {
    yaw_y();
  } else if (move_yaw) {
    yaw();
  } else if (move_servo) {
    move_debug_servo();
  } else if (move_leg) {
    move_debug_leg();
  }

/*
   -------------------------------------------------------
   Check State Machines
    :check active state machine(s) for execution time by its respective interval
   -------------------------------------------------------
*/
  if (moveDelayInterval && millis() - lastMoveDelayUpdate > moveDelayInterval) {
    delay_sequences();
  }

  if (nrf_active) {
    if (millis() - lastRemoteUpdate > remoteInterval) {
      remote_check();
    }
  }

  if (serial_active) {
    if (millis() - lastSerialUpdate > serialInterval) serial_check();
  }

  if (pir_active) {
    if (millis() - lastPIRUpdate > pirInterval) pir_check();
  }

  if (mpu_active) {
    if(millis() - lastMPUUpdate > mpuInterval) get_mpu();
  }

  if (uss_active) {
    if (millis() - lastUSSUpdate > ussInterval) uss_check();
  }

  if (amp_active) {
    if (ampInterval && millis() - lastAmpUpdate > ampInterval) amperage_check(amp_loop);
  }

  if (batt_active) {
    if(millis() - lastBatteryUpdate > batteryInterval) battery_check(0);
  }

  if (mp3_active && mp3_status) {
    if(millis() - lastMP3Update > mp3Interval) check_mp3();
  }
  if (potInterval && millis() - lastPotUpdate > potInterval) mp3_volume(-1);
}



/*
   -------------------------------------------------------
   Hardware Functions
   -------------------------------------------------------
*/
/*
   -------------------------------------------------------
   Update Servos
    :check if servo(s) need updating
    :this is the core functionality of Nova
   -------------------------------------------------------
*/
void update_servos() {
  //update coxas
  s_RFC.Update();
  s_LFC.Update();
  s_RRC.Update();
  s_LRC.Update();

  //update femurs
  s_RFF.Update();
  s_LFF.Update();
  s_RRF.Update();
  s_LRF.Update();

  //update tibias
  s_RFT.Update();
  s_LFT.Update();
  s_RRT.Update();
  s_LRT.Update();
}


/*
   -------------------------------------------------------
   NRF Check
    :provide general description and explanation here
   -------------------------------------------------------
*/
bool nrf_check() {
  bool resp = false;

  if (nrf_radio.available()) {
    uint8_t bytes = nrf_radio.getDynamicPayloadSize();
    if (bytes > sizeof(rc_data)) {
      // Packet is too large, it's corrupted or invalid.
      // We must read it to clear it from the NRF buffer, but we shouldn't overflow rc_data.
      uint8_t dummy[32];
      nrf_radio.read(&dummy, bytes);
      return false; // discard
    }
    
    nrf_radio.read(&rc_data, bytes);
    
    // Validate packet: buttons and selectors should only ever be 0 or 1.
    // If we receive a packet with random noise that passes the 16-bit CRC (1 in 65536 chance), 
    // it will have random values > 1 for these byte fields.
    // Exception: If it's an image chunk, rc_data[0] == 255.
    if (rc_data[0] != 255) {
      if (rc_data[0] > 1 || rc_data[1] > 1 || rc_data[2] > 1 || rc_data[3] > 1 ||
          rc_data[4] > 1 || rc_data[5] > 1) {
        nrf_radio.flush_rx();
        return false; // Corrupted packet masquerading as valid
      }
    }

    resp = true;

    //send data as acknowledgement
    nrf_ack();

    // Check for Image chunk
    if (rc_data[0] == 255) {
      if (slave_active || oled_active) {
        Wire1.beginTransmission((uint8_t)SLAVE_ID);
        for (int i = 0; i < 14; i++) {
          Wire1.write(rc_data[i]);
        }
        Wire1.endTransmission();
      }
      return true; // Skip normal parsing
    }

    //set remote control vars from nrf received data
    //fire buttons
    btn1 = rc_data[0];
    btn2 = rc_data[1];
    btn3 = rc_data[2];
    btn4 = rc_data[3];

    //sel stop buttons
    sel1 = rc_data[4];
    sel2 = rc_data[5];

    //slide pots
    p1 = rc_data[6];
    p2 = rc_data[7];
    p3 = rc_data[8];
    p4 = rc_data[9];

    //joysticks
    lx = rc_data[10];
    ly = rc_data[11];
    rx = rc_data[12];
    ry = rc_data[13];

    if (debug8) {
      for (int i = 0; i < data_num; i++) {
        Serial.print(rc_data[i]);Serial.print("\t");
      }
      Serial.println(" DATA REC");
    }
    
    // Detailed remote control debug: only print when something interesting arrives
    if (debug1) {
      bool has_action = (sel2 != 0 || p2 != 0 || ry != 127 || lx != 127 || ly != 127 || rx != 127 ||
                         btn1 != 0 || btn2 != 0 || btn3 != 0 || btn4 != 0);
      if (has_action) {
        Serial.print(F("[NRF_RX] sel2=")); Serial.print(sel2);
        Serial.print(F(" p2=")); Serial.print(p2);
        Serial.print(F(" lx=")); Serial.print(lx);
        Serial.print(F(" ly=")); Serial.print(ly);
        Serial.print(F(" rx=")); Serial.print(rx);
        Serial.print(F(" ry=")); Serial.print(ry);
        if (btn1||btn2||btn3||btn4) {
          Serial.print(F(" btn=")); Serial.print(btn1);Serial.print(btn2);Serial.print(btn3);Serial.print(btn4);
        }
        Serial.println();
      }
    }
    lastNRFUpdate = millis();
  }

  return resp;
}


void nrf_ack() {

    //set data
    float bv = (batt_voltage / 2) * 10;
    tm_data[0] = bv;
    tm_data[1] = spd;
    tm_data[2] = sound_vol;
    tm_data[3] = move_steps;
    tm_data[4] = (step_weight_factor_front * 100);
    tm_data[5] = (step_weight_factor_rear * 100);
    tm_data[6] = remote_select;
    tm_data[7] = start_mode;
    tm_data[8] = mpu_active;
    tm_data[9] = constrain(distance_l, 0, 255);   // left USS distance (cm)
    tm_data[10] = constrain(distance_r, 0, 255);  // right USS distance (cm)
    
    if (debug8) {
      for (int i = 0; i < data_num; i++) {
        Serial.print(tm_data[i]);Serial.print("\t");
      }
      Serial.println(" ACK SENT");
    }
    nrf_radio.writeAckPayload(1, &tm_data, sizeof(tm_data)); // load the payload for the next time
}



/*
   -------------------------------------------------------
   Remote Check
    :provide general description and explanation here - too much to comment by line
   -------------------------------------------------------
*/
void remote_check() {

  // NRF disconnect failsafe: if no radio data for 1 second, stop everything
  if (lastNRFUpdate > 0 && (millis() - lastNRFUpdate > 1000)) {
    if (start_mode != 0 || move_march || move_trot || move_follow) {
      if (debug) Serial.println(F("NRF TIMEOUT: Controller disconnected, stopping robot"));
      set_stop_active();
      set_stop();
      move_march = 0;
      move_forward = 0;
      move_backward = 0;
      move_left = 0;
      move_right = 0;
      move_trot = 0;
      move_follow = 0;
      remote_start_stop = 0;
      start_mode = 0;
      y_dir = 0; x_dir = 0; z_dir = 0;
    }
    
    // Auto-recover NRF24L01 if offline for more than 2 seconds (e.g. brownout freeze)
    if (millis() - lastNRFUpdate > 2000) {
      if (debug) Serial.println(F("NRF OFFLINE: Attempting hardware re-init..."));
      nrf_radio.begin();
      nrf_radio.setPALevel(RF24_PA_LOW);
      nrf_radio.setPayloadSize(sizeof(rc_data));
      nrf_radio.setChannel(124);
      nrf_radio.openReadingPipe(1, address[!radioNumber]);
      nrf_radio.enableAckPayload();
      nrf_radio.startListening();
      nrf_radio.writeAckPayload(1, &tm_data, sizeof(tm_data));
      lastNRFUpdate = millis(); // Reset so we wait a full 2s before trying again
    }
    return;
  }

  if (nrf_check()) {

    // ===== Special commands via p2 (always processed, even during demos) =====
    // p2 == 1: Home command
    // p2 == 2: Toggle MPU on/off
    // p2 == 11-15: Direct mode selection (1-5)
    if (p2 >= 1 && p2 != p2p) {
      if (p2 == 1) {
        // HOME: stop everything, smoothly go to home position
        set_stop_active();
        set_stop();
        move_march = 0;
        move_forward = 0;
        move_backward = 0;
        move_left = 0;
        move_right = 0;
        move_trot = 0;
        move_follow = 0;
        remote_start_stop = 0;
        start_mode = 0;
        y_dir = 0; x_dir = 0; z_dir = 0;
        fast_home_carpet();  // fast sequential leg lift homing to relieve carpet tension
        if (debug) Serial.println(F("Remote: HOME (Sequential Carpet Relief)"));
      } else if (p2 == 2) {
        // Toggle MPU
        if (mpu_active) {
          mpu_active = 0;
          set_stay();
          if (debug) Serial.println(F("Remote: MPU OFF"));
        } else {
          if (mpu_is_active) {
            mpu_active = 1;
            mroll = 0.0; mpitch = 0.0; myaw = 0.0;
            mroll_prev = 0.0; mpitch_prev = 0.0;
            gyroAngleX = 0.0; gyroAngleY = 0.0;
            accAngleX = 0.0; accAngleY = 0.0;
            currentTime = millis();
            if (debug) Serial.println(F("Remote: MPU ON"));
          } else {
            if (debug) Serial.println(F("Remote: MPU Hardware Not Detected"));
          }
        }
      } else if (p2 == 3) {
        // SIT
        set_stop_active();
        set_stop();
        move_march = 0; move_forward = 0; move_backward = 0;
        move_left = 0; move_right = 0; move_trot = 0; move_follow = 0;
        remote_start_stop = 0; start_mode = 0;
        y_dir = 0; x_dir = 0; z_dir = 0;
        set_sit();
        if (debug) Serial.println(F("Remote: SIT"));
      } else if (p2 == 4) {
        // LAY DOWN / CROUCH
        set_stop_active();
        set_stop();
        move_march = 0; move_forward = 0; move_backward = 0;
        move_left = 0; move_right = 0; move_trot = 0; move_follow = 0;
        remote_start_stop = 0; start_mode = 0;
        y_dir = 0; x_dir = 0; z_dir = 0;
        set_crouch();
        if (debug) Serial.println(F("Remote: LAY DOWN"));
      } else if (p2 == 5) {
        // Show Custom Image on OLED
        if (oled_active) {
          oled_request((char*)"z");
        }
        if (debug) Serial.println(F("Remote: CUSTOM IMAGE OLED"));
      } else if (p2 >= 11 && p2 <= 15) {
        if (remote_select != p2 - 10) {
          remote_select = p2 - 10;
          remote_start_stop = 0;
          start_mode = 0;
          set_stop_active();
          if (debug) { Serial.print(F("Remote: Direct Mode ")); Serial.println(remote_select); }
        }
      }
      p2p = p2;
    } else if (p2 == 0 && p2p != 0) {
      p2p = 0; // reset previous when key released
    }

    if (!move_demo && !move_funplay) {
/*
Serial.print("here1 : sel1 / sel1p ");
Serial.print(sel1);
Serial.print(" / ");
Serial.print(sel1p);
Serial.print("   sel2 / sel2p ");
Serial.print(sel2);
Serial.print(" / ");
Serial.println(sel2p);
*/      

      //start button by mode
      if (sel2 && sel2 != sel2p) {
        if (!remote_start_stop) {
          remote_start_stop = 1;
          if (debug1)
            Serial.println(F("Start Pressed"));

          if (remote_select == 1) {
            //march
            start_mode = 1;
            if (mp3_active) mp3_play(25);
            if (debug1)
              Serial.println(F("start march"));
            if (!move_march) {
              set_stop();
              y_dir = 0;
              x_dir = 0;
              z_dir = 0;
              if (mpu_is_active) mpu_active = 0;
              move_march = 1;
              if (oled_active) {
                oled_request((char*)"d");
              }
            }
          } else if (remote_select == 2) {
            //walk
            start_mode = 2;
          } else if (remote_select == 3) {
            //freestyle
            start_mode = 3;
          } else if (remote_select == 4) {
            //trot
            start_mode = 4;
            move_trot = 1;
          } else if (remote_select == 5) {
            //follow
            start_mode = 5;
            if (!move_follow) {
              if (debug1)
                Serial.println(F("move follow on"));
              spd_lock = spd;
              spd = 3;
              set_speed();
              move_follow = 1;
              if (mp3_active) {
                mp3_play(23);
                delay(1500);
              }
              if (mpu_is_active) mpu_active = 0;
              if (uss_is_active) uss_active = 0;
            }
          }
        } else {
          remote_start_stop = 0;
          start_mode = 0;
          if (debug1)
            Serial.println(F("Stop Pressed"));
          if (remote_select == 1) {
            if (mp3_active) mp3_play(25);
            if (move_march) {
              if (debug1)
                Serial.println(F("stop march"));
              move_march = 0;
              set_stop();
              y_dir = 0;
              x_dir = 0;
              z_dir = 0;
              if (oled_active) {
                oled_request((char*)"d");
              }
            }
          } else if (remote_select == 2) {
          } else if (remote_select == 3) {
          } else if (remote_select == 4) {
            move_trot = 0;
          } else if (remote_select == 5) {
            if (move_follow) {
              if (debug1)
                Serial.println(F("move follow off"));
              move_follow = 0;
              set_stop();
              if (mp3_active) {
                mp3_play(24);
              }
              if (uss_is_active) uss_active = 1;
            }
          }
          set_stop_active();
        }
      }
      if (sel2 != sel2p) {
        sel2p = sel2;
      }


      //select / set mode button
      if (sel1 && sel1 != sel1p) {
        (remote_select < 5) ? remote_select++ : remote_select = 1;
        if (debug1) {
          Serial.print(F("\tSelected ")); Serial.println(remote_select);
        }
        remote_start_stop = 0;
        start_mode = 0;
        set_stop_active();

        if (rgb_active) {
          if (remote_select == 1) {
            if (mp3_active) mp3_play(12);
            rgb_request((char*)"tEn");
          } else if (remote_select == 2) {
            if (mp3_active) mp3_play(13);
            rgb_request((char*)"uEn");
          } else if (remote_select == 3) {
            if (mp3_active) mp3_play(14);
            rgb_request((char*)"vEn");
          } else if (remote_select == 4) {
            if (mp3_active) mp3_play(15);
            rgb_request((char*)"wEn");
          } else if (remote_select == 5) {
            if (mp3_active) mp3_play(26);
            rgb_request((char*)"xEn");
          }
        }
        if (oled_active) {
          if (remote_select == 1) {
            oled_request((char*)"g");
          } else if (remote_select == 2) {
            oled_request((char*)"h");
          } else if (remote_select == 3) {
            oled_request((char*)"i");
          } else if (remote_select == 4) {
            oled_request((char*)"j");
          } else if (remote_select == 5) {
            oled_request((char*)"x");
          }
        }
      }
      if (sel1 != sel1p) {
        sel1p = sel1;
      }


      //joysticks
      if ((remote_select == 1 && start_mode == 1) || (remote_select == 4 && start_mode == 4)) {

        //gait joysticks for stationary marching
        y_dir = map(ry, 0, 255, y_dir_steps[1], y_dir_steps[0]);
        x_dir = map(lx, 0, 255, x_dir_steps[1], x_dir_steps[0]);
        z_dir = map(ly, 0, 255, z_dir_steps[1], z_dir_steps[0]);

      } else if (remote_select == 2 && start_mode == 2) {

        //gait joysticks for direction marching
        z_dir = map(ly, 0, 255, z_dir_steps[1], z_dir_steps[0]);

        //right y joystick
        y_dir = map(ry, 0, 255, y_dir_steps[1], y_dir_steps[0]);
        if (y_dir > 2) {
          if (!move_forward) {
            if (debug1)
              Serial.println(F("forward"));
            if (mpu_is_active) mpu_active = 0;
            move_march = 1;
            move_forward = 1;
          }
        } else if (y_dir < -2) {
          if (!move_backward) {
            if (debug1)
              Serial.println(F("backward"));
            if (mpu_is_active) mpu_active = 0;
            move_march = 1;
            move_backward = 1;
          }
        } else {
          if (move_forward) {
            move_forward = 0;
            if (debug1)
              Serial.println(F("stop forward"));
          }
          if (move_backward) {
            move_backward = 0;
            if (debug1)
              Serial.println(F("stop backward"));
          }
          if (move_march) {
            move_march = 0;
            if (rgb_active) {
              rgb_request((char*)"OtEn");
            }
          }
        }

        //left x joystick modifier
        x_dir = map(lx, 0, 255, x_dir_steps[1], x_dir_steps[0]);
        if (x_dir > 2) {
          if (!move_right) {
            move_right = 1;
            if (debug1)
              Serial.println(F("move right"));
          }
        } else if (x_dir < -2) {
          if (!move_left) {
            move_left = 1;
            if (debug1)
              Serial.println(F("move left"));
          }
        } else {
          if (move_right) {
            move_right = 0;
            if (debug1)
              Serial.println(F("stop move right"));
          }
          if (move_left) {
            move_left = 0;
            if (debug1)
              Serial.println(F("stop move left"));
          }
          if (!move_forward && !move_backward) {
            set_stop();
          }
        }
      } else if (remote_select == 3 && start_mode == 3) {

        //kinematics joysticks
        if (btn1) {
        } else {
          move_steps_x = map(lx, 0, 255, (move_steps_max / 2), (move_steps_min / 2));
          move_roll_x = 1;
          if (debug1 && move_steps_x) {
            Serial.print(F("move roll_x "));Serial.println(move_steps_x);
          }

          move_steps_y = map(ly, 0, 255, (move_steps_max * 1.4), (move_steps_min * 1.4));
          move_pitch_y = 1;
          if (debug1 && move_steps_y) {
            Serial.print(F("move pitch_y "));Serial.println(move_steps_y);
          }
        }

        if (btn2) {
          //move yaw while button pressed/held
          move_steps_yaw = map(rx, 0, 255, (move_steps_max * 1.4), (move_steps_min * 1.4));
          if (move_steps_yaw > 2 || move_steps_yaw < -2) {
            move_yaw = 1;
            if (debug1)
              Serial.println(F("move yaw"));
          } else {
            move_yaw = 0;
          }

          //move in y while button pressed/held
          move_steps_ky = map(ry, 0, 255, (move_steps_min * 1.4), (move_steps_max * 1.4));
          if (move_steps_ky > 2 || move_steps_ky < -2) {
            move_kin_y = 1;
            if (debug1)
              Serial.println(F("move kin_y"));
          } else {
            move_kin_y = 0;
          }
        } else {
          move_steps_yaw_x = map(rx, 0, 255, (move_steps_max * .5), (move_steps_min * .5));
          if (move_steps_yaw_x > 2 || move_steps_yaw_x < -2) {
            move_yaw_x = 1;
            if (debug1)
              Serial.println(F("move yaw_x"));
          } else {
            move_yaw_x = 0;
          }

          move_steps_yaw_y = map(ry, 0, 255, move_steps_max, move_steps_min);
          if (move_steps_yaw_y > 2 || move_steps_yaw_y < -2) {
            move_yaw_y = 1;
            if (debug1)
              Serial.println(F("move yaw_y"));
          } else {
            move_yaw_y = 0;
          }
        }  
      } else if (remote_select == 5 && start_mode == 5) {
//DEV: unused
      }

      //check fire buttons
      int fired1 = 0;
      if ((btn1 && btn1 != btn1p) && (btn2 && btn2 != btn2p)) {      //press both btn1 and btn2        
          fired1 = 1;
          btn1p = btn1;
          btn2p = btn2;
          if (remote_select == 1 || remote_select == 2 || remote_select == 3 || remote_select == 4 || remote_select == 5) {
            set_stop();
            if (debug1)
              Serial.println(F("stay"));
            if (rgb_active) {
              rgb_request((char*)"Hg");
            }
            set_stay();
            if (oled_active) {
              oled_request((char*)"b");
            }
          }
      }

      int fired2 = 0;
      if ((btn3 && btn3 != btn3p) && (btn4 && btn4 != btn4p)) {      //press both btn3 and btn4        
          fired2 = 1;
          btn3p = btn3;
          btn4p = btn4;
          if (remote_select == 1 || remote_select == 2 || remote_select == 3 || remote_select == 4 || remote_select == 5) {
            set_stop();
            if (rgb_active) {
              rgb_request((char*)"Hg");
            }
            if (debug1)
              Serial.println(F("wake"));
            spd_lock = spd;
            spd = 1;
            set_speed();
            move_loops = 3;
            move_switch = 2;
            move_wake = 1;
          }
      }

      if (!fired1 && !fired2) {
        //btn1
        if (btn1 != btn1p) {                //btn1 pressed
          btn1p = btn1;
          if (btn1) {
            set_stop();
            if (remote_select == 1) {
              ramp_dist = 0.33;
              ramp_spd = 1.5;
              use_ramp = 1;  
            } else if (remote_select == 2) {
              if (!move_roll) {
                move_roll = 1;
                if (debug1)
                  Serial.println(F("move roll"));
              }
            } else if (remote_select == 3) {
//DEV: unused
            } else if (remote_select == 4) {
              set_sit();
              if (rgb_active) 
                rgb_request((char*)"Hi");
              if (debug1)
                Serial.println(F("sit"));
            } else if (remote_select == 5) {
//DEV: unused
            }
          } else {                          //btn1 released
            if (remote_select == 1) {
              use_ramp = 0;
            } else if (remote_select == 2) {
              if (move_roll) {
                move_roll = 0;
                if (debug1)
                  Serial.println(F("stop roll"));
              }
            } else if (remote_select == 3) {
//DEV: unused
            } else if (remote_select == 4) {
//DEV: unused
            } else if (remote_select == 5) {
//DEV: unused
            }
          }
        }  
  
  
        //btn2
        if (btn2 != btn2p) {                //btn2 pressed
          btn2p = btn2;
          if (btn2) {
            set_stop();
            if (remote_select == 1) {
            } else if (remote_select == 2) {
              if (!move_pitch) {
                move_pitch = 1;
                if (debug1)
                  Serial.println(F("move pitch"));
              }
            } else if (remote_select == 3) {
//DEV: unused
            } else if (remote_select == 4) {
              set_kneel();
              if (debug1)
                Serial.println(F("kneel"));
            } else if (remote_select == 5) {
//DEV: unused
            }
          } else {                          //btn2 released
            if (remote_select == 1) {
            } else if (remote_select == 2) {
              if (move_pitch) {
                move_pitch = 0;
                if (debug1)
                  Serial.println(F("stop pitch"));
              }
            } else if (remote_select == 3) {
//DEV: unused
            } else if (remote_select == 4) {
//DEV: unused
            } else if (remote_select == 5) {
//DEV: unused
            }
          }
        }  
  
        //btn3
        if (btn3 != btn3p) {                //btn3 pressed
          btn3p = btn3;
          if (btn3) {
            set_stop();
            if (remote_select == 1) {
            } else if (remote_select == 2) {
              if (!move_roll_body) {
                move_roll_body = 1;
                if (debug1)
                  Serial.println(F("move roll body"));
              }
            } else if (remote_select == 3) {
//DEV: unused
            } else if (remote_select == 4) {
              set_crouch();
              if (rgb_active)
                rgb_request((char*)"Hh");
              if (debug1)
                Serial.println(F("crouch"));
            } else if (remote_select == 5) {
//DEV: unused
            }
          } else {                          //btn3 released
            if (remote_select == 1) {
            } else if (remote_select == 2) {
              if (move_roll_body) {
                move_roll_body = 0;
                if (debug1)
                  Serial.println(F("stop roll body"));
              }
            } else if (remote_select == 3) {
//DEV: unused
            } else if (remote_select == 4) {
//DEV: unused
            } else if (remote_select == 5) {
//DEV: unused
            }
          }
        }  
  
        //btn4
        if (btn4 != btn4p) {                //btn4 pressed
          btn4p = btn4;
          if (btn4) {
            set_stop();
            if (remote_select == 1) {
            } else if (remote_select == 2) {
              if (!move_pitch_body) {
                move_pitch_body = 1;
                if (debug1)
                  Serial.println(F("move pitch body"));
              }
            } else if (remote_select == 3) {
//DEV: unused
            } else if (remote_select == 4) {
              set_lay();
              if (rgb_active)
                rgb_request((char*)"Kd");
              if (debug1)
                Serial.println(F("lay"));
            } else if (remote_select == 5) {
//DEV: unused
            }
          } else {                          //btn4 released
            if (remote_select == 1) {
            } else if (remote_select == 2) {
              if (move_pitch_body) {
                move_pitch_body = 0;
                if (debug1)
                  Serial.println(F("stop pitch body"));
              }
            } else if (remote_select == 3) {
//DEV: unused
            } else if (remote_select == 4) {
//DEV: unused
            } else if (remote_select == 5) {
//DEV: unused
            }
          }
        }  
      }  


/*  
//DEV: these are really just test / demo moves, may not be worth keeping

        //left y joystick
        int my = map(ly, 0, 255, 0, 255);
        if (my > 200) {
          if (!move_trot) {
            set_stop();
            step_lock = 1;
            move_trot = 1;
            if (debug1)
              Serial.println(F("move trot"));
            x_dir = map(rx, 0, 255, move_steps_min / 4, move_steps_max / 4);
            move_steps = map(ry, 0, 255, move_steps_max / 2, move_steps_min / 2);
            if (debug2)
              Serial.print(F("x dir: ")); Serial.print(x_dir);
          }
        } else {
          set_stop();
          if (move_trot) {
            move_trot = 0;
          }
        }

      //SHAPE BUTTONS
      if (ps2x.ButtonPressed(PSB_TRIANGLE)) {
        if (remote_select == 1) {
          set_stop();
          if (!move_y_axis) {
            move_y_axis = 1;
            if (debug1)
              Serial.println(F("move y_axis"));
          }
        } else if (remote_select == 2) {
          set_stop();
          if (!move_wman) {
            move_wman = 1;
            if (debug1)
              Serial.println(F("move wman"));
          }
        }
      } else if (ps2x.ButtonReleased(PSB_TRIANGLE)) {
        if (remote_select == 1) {
          if (move_y_axis) {
            move_y_axis = 0;
            if (debug1)
              Serial.println(F("stop y_axis"));
          }
        } else if (remote_select == 2) {
          if (move_wman) {
            move_wman = 0;
            if (debug1)
              Serial.println(F("stop wman"));
          }
        }
      }

  
      if (ps2x.ButtonPressed(PSB_CROSS)) {
        if (remote_select == 1) {
          set_stop();
          if (!move_x_axis) {
            move_x_axis = 1;
            if (debug1)
              Serial.println(F("move x_axis"));
          }
        }
      } else if (ps2x.ButtonReleased(PSB_CROSS)) {
        if (remote_select == 1) {
          if (move_x_axis) {
            move_x_axis = 0;
            if (debug1)
              Serial.println(F("stop x_axis"));
          }
        }
      }
*/  


      //set speed from remote controller via p1 (1 to 30 ms delay, lower is faster)
      if (p1 > 0 && p1 != p1p) {
        p1p = p1;
        if (remote_select == 1 || remote_select == 2 || remote_select == 3 || remote_select == 4 || remote_select == 5) {
          spd = (float)p1;
          if (spd < 1.0) spd = 1.0;
          if (spd > 30.0) spd = 30.0;
          set_speed();
          if (debug1) {
            Serial.print(F("set speed : "));
            Serial.println(spd);
          }
        }
      }
    }
  }

  lastRemoteUpdate = millis();
}



/*
   -------------------------------------------------------
   PIR Check
    :provide general description and explanation here
   -------------------------------------------------------
*/
void pir_check() {
  int mactive = mpu_active;
  int uactive = uss_active;

    if (move_follow) {
      follow();
    } else if (!pir_halt) {
      pir_val = digitalRead(PIR_FRONT);
      pir_wait--;
      if (pir_val == HIGH) {
        if (pir_state == LOW) {
          if (pir_wait < 1) {
            if (rgb_active) {
              rgb_request((char*)"Fh");
            }
            if (debug1)
              Serial.println(F("Motion detected!"));
    
            //disable mpu and uss sensors while in alert
            if (mpu_active) mpu_active = 0;
            if (uss_active) uss_active = 0;
    
            set_stop_active();
            pir_state = HIGH;
            for (int l = 0; l < TOTAL_LEGS; l++) {
              servoSequence[l] = 0;
            }
            for (int m = 0; m < TOTAL_SERVOS; m++) {
              if (is_left_leg(m)) {
                if (!is_front_leg(m) && (is_femur(m) || is_tibia(m))) {
                  servoStepMoves[m][0] = limit_target(m, (servoHome[m] - 30), 0);
                } else if (is_front_leg(m) && (is_femur(m) || is_tibia(m))) {
                  servoStepMoves[m][0] = limit_target(m, (servoHome[m] - 60), 0);
                } else if (is_front_leg(m)) {
                  servoStepMoves[m][0] = limit_target(m, (servoHome[m] - 20), 0);
                  servoStepMoves[m][1] = limit_target(m, (servoHome[m] + 35), 0);
                } else {
                  servoStepMoves[m][1] = limit_target(m, (servoHome[m] + 35), 0);
                }
              } else {
                if (!is_front_leg(m) && (is_femur(m) || is_tibia(m))) {
                  servoStepMoves[m][0] = limit_target(m, (servoHome[m] + 30), 0);
                } else if (is_front_leg(m) && (is_femur(m) || is_tibia(m))) {
                  servoStepMoves[m][0] = limit_target(m, (servoHome[m] + 60), 0);
                } else if (is_front_leg(m)) {
                  servoStepMoves[m][0] = limit_target(m, (servoHome[m] + 20), 0);
                  servoStepMoves[m][1] = limit_target(m, (servoHome[m] + 35), 0);
                } else {
                  servoStepMoves[m][1] = limit_target(m, (servoHome[m] + 35), 0);
                }
              }
              servoStepMoves[m][2] = servoHome[m];
            }
            spd_c = 1;
            spd_f = 1;
            spd_t = 1;
            move_loops = 0;
            move_delay = 300;
            move_sequence = 1;
    
            if (oled_active) {
              oled_request((char*)"e");
            } else {
              if (debug1)
                Serial.println(F("INTRUDER ALERT!"));
            }

//DEV: add mp3_active and play

            if (rgb_active) {
              rgb_request((char*)"Fj");
            }
          }
        }
      } else {
        if (pir_state == HIGH) {
          Serial.println(F("Motion ended!"));
          pir_state = LOW;
          pir_wait = 100; //state machine cycles, not ms
          if (oled_active) {
            oled_request((char*)"f");
          } else {
            if (debug1)
              Serial.println(F("ALERT COMPLETE!"));
          }
    
          pwm_oe = 0;
          pir_reset = 1;
        } else if (pir_reset) {
          if (!move_sequence) {
            pir_reset = 0;
            move_delays[0] = 3000;
            move_delay_sequences[0] = 7;
            move_delays[1] = 3000;
            move_delay_sequences[1] = 7;
            delay_sequences();
    
            if (rgb_active) {
              rgb_request((char*)"Jf");
            }
          }
          if (oled_active) {
            oled_request((char*)"f");
          }
    
          //re-enable mpu and uss sensors if enabled prior to alert
          mpu_active = mactive;
          uss_active = uactive;
        }
      }
    }

    lastPIRUpdate = millis();
}


void follow() {
  byte reset_scnt = 0;
  if (sound_cur == 0) {
    sound_cur = 25;
  }

  if (pir_wait) {
    pir_wait--;
  } else {
    int val_front = pir_frontState = digitalRead(PIR_FRONT);
    if (val_front == HIGH) {
      if (pir_frontState == LOW) {
        pir_frontState = HIGH;
      }
    } else {
      if (pir_frontState == HIGH) {
        pir_frontState = LOW;
      }
    }
  
    int val_left = pir_leftState = digitalRead(PIR_LEFT);
    if (val_left == HIGH) {            
      if (pir_leftState == LOW) {
        pir_leftState = HIGH;
      }
    } else {
      if (pir_leftState == HIGH) {
        pir_leftState = LOW;
      }
    }
  
    int val_right = pir_rightState = digitalRead(PIR_RIGHT);
    if (val_right == HIGH) {            
      if (pir_rightState == LOW) {
        pir_rightState = HIGH;
      }
    } else {
      if (pir_rightState == HIGH) {
        pir_rightState = LOW;
      }
    }

/*
    if (debug1) {
      Serial.print("F: ");Serial.print(pir_frontState);
      Serial.print("L: ");Serial.print(pir_leftState);
      Serial.print("R: ");Serial.println(pir_rightState);
    }
*/

    if (pir_frontState || pir_leftState || pir_rightState) {
      pir_wait = pirDelay;
      y_dir = 0;
      x_dir = 0;
      z_dir = 0;
    }

    if (move_wake) {
      set_stop();
      move_wake = 0;
    } else {
      if (!move_march && (pir_frontState || pir_leftState || pir_rightState) && !(pir_frontState && pir_leftState && pir_rightState)) {
        if (debug1)
          Serial.println("restart!");
//        move_steps = 25;
        if (mpu_is_active) mpu_active = 0;
        move_march = 1;

        pir_frontState = LOW;
        pir_leftState = LOW;
        pir_rightState = LOW;
      }  
  
      if (pir_frontState && !pir_leftState && !pir_rightState) {
        follow_dir = 1;
        if (debug1)
          Serial.println("go forward");
        y_dir = 15;
        if (sound_cur != 10) {
          sound_cur = 10;
          reset_scnt = 1;
        }
      } else if (pir_frontState && pir_leftState && !pir_rightState) {
        follow_dir = 2;
        if (debug1)
          Serial.println("go forward-left");
        y_dir = 10;
        x_dir = 10;
        if (sound_cur != 6) {
          sound_cur = 6;
          reset_scnt = 1;
        }
      } else if (pir_frontState && !pir_leftState && pir_rightState) {
        follow_dir = 3;
        if (debug1)
          Serial.println("go forward-right");
        y_dir = 10;
        x_dir = -10;
        if (sound_cur != 6) {
          sound_cur = 6;
          reset_scnt = 1;
        }
      } else if (!pir_frontState && pir_leftState && !pir_rightState) {
        follow_dir = 4;
        if (debug1)
          Serial.println("go left");
        y_dir = 5;
        x_dir = -15;
        if (sound_cur != 3) {
          sound_cur = 3;
          reset_scnt = 1;
        }
      } else if (!pir_frontState && !pir_leftState && pir_rightState) {
        follow_dir = 5;
        if (debug1)
          Serial.println("go right");
        y_dir = 5;
        x_dir = 15;
        if (sound_cur != 3) {
          sound_cur = 3;
          reset_scnt = 1;
        }
      } else if (!pir_frontState && pir_leftState && pir_rightState) {
        follow_dir = 6;
        if (debug1)
          Serial.println("go back");
        y_dir = -15;
        x_dir = 0;
        if (sound_cur != 2) {
          sound_cur = 2;
          reset_scnt = 1;
        }
      } else if (pir_frontState && pir_leftState && pir_rightState) {
        follow_dir = 7;
        if (debug1)
          Serial.println("greet");
        move_loops = 2;
        move_switch = 2;
        move_wake = 1;
        move_march = 0;
      } else {
        follow_dir = 0;
        if (debug1)
          Serial.println("stop!");
        pir_repeat_cnt++;
        if (pir_repeat_cnt == 6) {
          set_stop();
          move_march = 0;
          pir_repeat_cnt = 0;
        }
        y_dir = 0;
        x_dir = 0;
        z_dir = 0;
        if (sound_cur != 25) {
          sound_cur = 25;
          reset_scnt = 1;
        }
      }

      if (oled_active) {
        switch (follow_dir) {
          case 0: oled_request((char*)"w"); break;
          case 1: oled_request((char*)"p"); break;
          case 2: oled_request((char*)"q"); break;
          case 3: oled_request((char*)"r"); break;
          case 4: oled_request((char*)"s"); break;
          case 5: oled_request((char*)"t"); break;
          case 6: oled_request((char*)"u"); break;
          case 7: oled_request((char*)"v"); break;
        }
      }
      if (mp3_active) {
        if (!sound_cnt || reset_scnt) {
          if (!pir_frontState && !pir_leftState && !pir_rightState) {
            mp3_play(6);
          }
          reset_scnt = 0;
          sound_cnt = sound_cur;
        } else {
          sound_cnt--;
        }
      }

      follow_dir_prev = follow_dir;
    }
  }

}




/*
   -------------------------------------------------------
   Check Ultrasonic Reading
    :provide general description and explanation here
   -------------------------------------------------------
*/
void uss_check() {
  //check right sensor
  int dist_rt = command_slave((char*)"b");
  if (dist_rt != prev_distance_r && ((dist_rt > (prev_distance_r + distance_tolerance)) || (dist_rt < (prev_distance_r - distance_tolerance)))) {
    distance_r = prev_distance_r = dist_rt;
  }

  //check left sensor
  int dist_lt = command_slave((char*)"a");
  if (dist_lt != prev_distance_l && ((dist_lt > (prev_distance_l + distance_tolerance)) || (dist_lt < (prev_distance_l - distance_tolerance)))) {
    distance_l = prev_distance_l = dist_lt;
  }

  if (debug7) {
    Serial.print(F("USS -> L: "));
    Serial.print(dist_lt);
    Serial.print(F(" cm | R: "));
    Serial.print(dist_rt);
    Serial.println(F(" cm"));
  }

  if (oled_active) {
    oled_request((char*)"c");
  }

  if (debug7) {
    Serial.print(F("USS LEFT: "));Serial.print(distance_l);
    Serial.print(F("USS RIGHT: "));Serial.println(distance_r);
  }



/*
  if (dist_rt && dist_lt && (dist_rt < distance_alarm || dist_lt < distance_alarm)) {
    distance_alarm_set++;

    if (debug7 && distance_alarm_set > 0) {
      Serial.print(F("USS ALARM #"));Serial.println(distance_alarm_set);
    }
    Serial.print(F("USS ALARM #"));Serial.println(distance_alarm_set);

    if (oled_active && distance_alarm_set < 3) {
      oled_request((char*)"c");
    } else {
      set_stop_active();
      if (oled_active) {
        oled_request((char*)"e");
      }
      rgb_request((char*)"MQNOFzn");
      delay(3000);
      set_stop();
      distance_alarm_set = 0;
    }
    
    if (debug7) {
      if (plotter) {
        Serial.print(F("Lt:"));
        if (distance_l > (distance_alarm*5)) {
          Serial.print((distance_alarm*5));
        } else {
          Serial.print(distance_l);
        }
        Serial.print(F("\t"));
        Serial.print(F("Rt:"));
        if (distance_r > (distance_alarm*5)) {
          Serial.print((distance_alarm*5));
        } else {
          Serial.print(distance_r);
        }
        Serial.print(F("\t"));
        Serial.println();
      } else {
        Serial.print(F("Dist Right: "));
        Serial.println(distance_r);
        Serial.print(F("Dist Left: "));
        Serial.println(distance_l);
      }
    }
  } else {
    distance_alarm_set = 0;
  }
*/

  lastUSSUpdate = millis();
}


/*
   -------------------------------------------------------
   Get MPU Data
    :provide general description and explanation here
   -------------------------------------------------------
*/
void get_mpu() {

  if (readByte(MPU6050_ADDRESS, INT_STATUS) & 0x01) {  // check if data ready interrupt
    readAccelData(accelCount);  // Read the x/y/z adc values
    getAres();
    
    // calculate the accleration value into actual g's
    ax = (float)accelCount[0]*aRes - accelBias[0];
    ay = (float)accelCount[1]*aRes - accelBias[1];   
    az = (float)accelCount[2]*aRes - accelBias[2];  

    // Calculating Roll and Pitch from the accelerometer data
    accAngleX = (atan(ay / sqrt(pow(ax, 2) + pow(az, 2))) * 180.0 / PI);
    accAngleY = (atan(-1.0 * ax / sqrt(pow(ay, 2) + pow(az, 2))) * 180.0 / PI);
   
    readGyroData(gyroCount);  // Read the x/y/z adc values
    getGres();
 
    // calculate the gyro value into actual degrees per second
    gx = (float)gyroCount[0]*gRes - gyroBias[0];
    gy = (float)gyroCount[1]*gRes - gyroBias[1];  
    gz = (float)gyroCount[2]*gRes - gyroBias[2];   

    previousTime = currentTime;
    currentTime = millis();
    elapsedTime = (float)(currentTime - previousTime) / 1000.0;
    if (elapsedTime <= 0.0 || elapsedTime > 0.1) elapsedTime = 0.01;

    // Complementary filter - combine accelerometer and gyro angle values
    mroll = (0.97 * (mroll + gx * elapsedTime) + 0.03 * accAngleX);
    mpitch = (0.97 * (mpitch + gy * elapsedTime) + 0.03 * accAngleY);
    myaw = (myaw + gz * elapsedTime);
  }  

  if (!plotter && debug5) {
    Serial.print(F("mpu roll/pitch:\t")); Serial.print(mroll); Serial.print(F("\t/\t")); Serial.println(mpitch);
  } else if (plotter && debug5) {
    Serial.print(F("roll:")); Serial.print(mroll); Serial.print(F("\tpitch:")); Serial.println(mpitch);
  }

  // Only apply stance leveling when robot is NOT actively executing walking gaits
  if (!move_forward && !move_backward && !move_left && !move_right && !move_trot && !move_march && !move_sequence) {
    if (!plotter) {
      set_axis(mroll, mpitch);
    }
  }

  lastMPUUpdate = millis();
}


/*
   -------------------------------------------------------
   Check Amperage Level
    :provide general description and explanation here
   -------------------------------------------------------
*/
void amperage_check(int aloop) {
  float AcsValue=0.0,Samples=0.0,AvgAcs=0.0,AcsValueF=0.0;

  for (int x = 0; x < 150; x++){ //Get 150 samples
    AcsValue = analogRead(AMP_PIN);     //Read current sensor values   
    Samples = Samples + AcsValue;  //Add samples together
//state machine this if possible... adds blocking delay to code, all be it miniscule!!
    delay(3); // let ADC settle before next sample 3ms
  }
  AvgAcs=Samples/150.0;//Taking Average of Samples
  AcsValueF = (2.5 - (AvgAcs * (5.0 / 1024.0)) )/0.177;
  
  AcsValueF = abs(AcsValueF)*1.8;
  if (debug4) {
    Serial.print(AvgAcs);
    Serial.print("/");
    Serial.print(AcsValueF);
    Serial.print("/");
    Serial.print(amp_limit);
  }
  if (AcsValueF > amp_limit) {
    ampInterval = 10;
    if (amp_cnt < amp_thresh) {
      amp_cnt++;
      rgb_request((char*)"u");
      if (debug4) {
        Serial.print("\tlimit met, counting... ");Serial.println(amp_cnt);
      }
    } else {
      rgb_request((char*)"A");
      detach_all();
      if (debug4) {
        Serial.println(F("\tthresh met, shutdown pwm!"));
      }
    }

    if (rgb_active) {
      rgb_request((char*)"MONRDn");
    }
  } else if (AcsValueF > amp_limit/2) {
    if (amp_cnt < amp_thresh) {
      rgb_request((char*)"u");
      amp_cnt++;
    } else {
      rgb_request((char*)"A");
      detach_all();
      if (debug4) {
        Serial.println(F("\tsoft thresh met, shutdown!"));
      }
    }
    ampInterval = 50;
    amp_warning = 2;

    if (rgb_active) {
      rgb_request((char*)"MTNRDn");
    }
    if (debug4) {
      Serial.print("\twarning 2 set - cnt: ");Serial.println(amp_cnt);
    }
  } else if (AcsValueF > amp_limit/3) {
    if (amp_cnt) {
      amp_cnt--;
    }
    rgb_request((char*)"t");
    ampInterval = 300;
    amp_warning = 1;

    if (rgb_active) {
      rgb_request((char*)"MPNRDn");
    }
    if (debug4) {
      Serial.print("\twarning 1 set - cnt: ");Serial.println(amp_cnt);
    }
  } else {
    if (amp_cnt) {
      amp_cnt--;
    }
    ampInterval = 1000;
    if (debug4) {
      Serial.print("\tcnt: ");Serial.println(amp_cnt);
    }
  }

  if (!aloop) {
    ampInterval = 0;
  }
   lastAmpUpdate = millis();
}

/*
   -------------------------------------------------------
   Check Battery Level
    :provide general description and explanation here
   -------------------------------------------------------
*/
void battery_check(byte bshow) {
  int syshalt = 0;
  int batt_danger = 0;
  int sensorValue = analogRead(BATT_MONITOR);
  batt_voltage = sensorValue * (3.3 / 1023.00) * 5.7;     // Convert the reading values from 3.3v to 12V

  if (batt_voltage && ((batt_voltage <= (batt_voltage_prev - .05)) || (batt_voltage >= (batt_voltage_prev + .05)) || bshow)) {
    if (batt_cnt == 3 || bshow) {
      if (batt_cnt > 1) {
        batt_voltage = avg_volts / batt_cnt;
      }
      for (int i = 0; i < 9; i++) {
        if (batt_voltage <= batt_levels[i]) {
          batt_danger++;
        } else if ((batt_voltage >= (batt_levels[i] - 0.02)) && (batt_voltage <= (batt_levels[i] + 0.02))) {
          batt_danger = i;
        }
      }

      if (debug4 || debug1) {
        Serial.print(batt_voltage); Serial.print(" volts - BATTERY LEVEL #"); Serial.println(batt_danger);
      }

      if (oled_active) {
        switch ((batt_danger)) {
          case 0: oled_request((char*)"0n"); if (mp3_active) mp3_play(18); break;
          case 1: oled_request((char*)"1n"); break;
          case 2: oled_request((char*)"2n"); if (mp3_active) mp3_play(18); break;
          case 3: oled_request((char*)"3n"); break;
          case 4: oled_request((char*)"4n"); if (mp3_active) mp3_play(19); break;
          case 5: oled_request((char*)"5n"); break;
          case 6: oled_request((char*)"6n"); if (mp3_active) mp3_play(20); break;
          case 7: oled_request((char*)"7n"); break;
          case 8: oled_request((char*)"8n"); if (mp3_active) mp3_play(21); break;
          case 9: oled_request((char*)"9n"); syshalt = 1; break;
          default: oled_request((char*)"9n"); syshalt = 1; break;
        }
      }
      batt_voltage_prev = batt_voltage;
      batt_cnt = 0;
      avg_volts = 0; 
       
      if (syshalt) {
        if (debug4 || debug1) {
          Serial.print(batt_voltage); Serial.println(F(" volts - SYSTEM HALTED!"));
        }
        powering_down();
        while(1) {           //simulate system halt
          if (oled_active) {
            oled_request((char*)"9n");
            delay(3000);
            oled_request((char*)"k");
            delay(3000);
          }
        }
      }
    } else {
      batt_cnt++;
      avg_volts += batt_voltage;
      if (debug4) {
        Serial.print("batt change #"); Serial.print(batt_cnt); 
        Serial.print(": sensor / volts "); Serial.print(sensorValue); Serial.print(F(" / ")); Serial.println(batt_voltage);
      }
    }
  }

  lastBatteryUpdate = millis();
}



/*
   -------------------------------------------------------
   Operational Functions
   -------------------------------------------------------
*/
void init_home() {
  for (int i = 0; i < TOTAL_SERVOS; i++) {
    for (int j = 0; j < 6; j++) {
      servoSweep[i][j] = 0;
    }
    for (int j = 0; j < 8; j++) {
      servoRamp[i][j] = 0;
    }

    servoDelay[i][0] = 0;
    servoDelay[i][1] = 0;
    servoStep[i] = 0;
    servoSwitch[i] = 0;
    servoSpeed[i] = (spd * 1.5);
    activeSweep[i] = 0;
  }

  for (int i = 0; i < TOTAL_LEGS; i++) {
    servoSequence[i] = 0;
  }

  //set to home positions directly
  for (int i = 0; i < TOTAL_SERVOS; i++) {
    servoPos[i] = servoHome[i];
    targetPos[i] = servoHome[i];
    activeServo[i] = 0;
  }

  //initiate servos in staged groups with settling delays to prevent high current brownouts
  //1. coaxes (horizontal shoulder alignment)
  pwm1.setPWM(servoSetup[RFC][1], 0, servoHome[RFC]);
  pwm1.setPWM(servoSetup[LFC][1], 0, servoHome[LFC]);
  pwm1.setPWM(servoSetup[RRC][1], 0, servoHome[RRC]);
  pwm1.setPWM(servoSetup[LRC][1], 0, servoHome[LRC]);
  delay(400);

  //2. tibias (leg lower extensions)
  pwm1.setPWM(servoSetup[RFT][1], 0, servoHome[RFT]);
  pwm1.setPWM(servoSetup[LFT][1], 0, servoHome[LFT]);
  pwm1.setPWM(servoSetup[RRT][1], 0, servoHome[RRT]);
  pwm1.setPWM(servoSetup[LRT][1], 0, servoHome[LRT]);
  delay(400);

  //3. femurs (main stance elevation)
  pwm1.setPWM(servoSetup[RFF][1], 0, servoHome[RFF]);
  pwm1.setPWM(servoSetup[LFF][1], 0, servoHome[LFF]);
  pwm1.setPWM(servoSetup[RRF][1], 0, servoHome[RRF]);
  pwm1.setPWM(servoSetup[LRF][1], 0, servoHome[LRF]);
  delay(500);

  //ensure all 12 servo channels are solidly written to hardware
  go_home();
  set_stay();
}


void detach_all() {
  if (debug4) {
    Serial.println(F("detaching all servos!"));
  }
  for (int i = 0; i < TOTAL_SERVOS; i++) {
    activeServo[i] = 0;
    activeSweep[i] = 0;
    pwm1.setPWM(i, 0, 0);
  }
  digitalWrite(OE_PIN, HIGH);
  digitalWrite(PWR_PIN, LOW);
  pwm_active = 0;
  amp_active = 0;

  if (rgb_active) {
    rgb_request((char*)"MONRAGn");
  }
}

void set_ramp(int servo, float sp, float r1_spd, float r1_dist, float r2_spd, float r2_dist) {
  servoRamp[servo][0] = sp;  //speed
  servoRamp[servo][1] = abs(servoPos[servo] - targetPos[servo]);  //set distance

  if (!r1_spd) r1_spd = sp + (sp * ramp_spd); 
  if (!r2_spd) r2_spd = sp + (sp * ramp_spd); 
  if (!r1_dist) r1_dist = (servoRamp[servo][1] * ramp_dist); 
  if (!r2_dist) r2_dist = (servoRamp[servo][1] * ramp_dist); 

  servoRamp[servo][2] = r1_spd;  //ramp up spd
  servoRamp[servo][3] = r1_dist;  //ramp up dist
  servoRamp[servo][4] = (servoRamp[servo][2]-sp);  //ramp up spd inc
  if (r1_dist != 0) {
    servoRamp[servo][4] = (servoRamp[servo][2]-sp)/r1_dist;  //ramp up spd inc
  }
  servoRamp[servo][5] = r2_spd;  //ramp down spd
  servoRamp[servo][6] = r2_dist;  //ramp down dist
  servoRamp[servo][7] = (servoRamp[servo][5]-sp);  //ramp down spd inc
  if (r2_dist != 0) {
    servoRamp[servo][7] = (servoRamp[servo][5]-sp)/r2_dist;  //ramp down spd inc
  }

  if (debug3 && servo == debug_servo) {
    Serial.print("set_ramp: sPos: "); Serial.print(servoPos[servo]);
    Serial.print("\ttPos: "); Serial.print(targetPos[servo]);
    Serial.print("\tr1_dist: "); Serial.print(r1_dist);
    Serial.print("\tr2_dist: "); Serial.println(r2_dist);
    Serial.print("ramp:"); 
    Serial.print("\t"); Serial.print(servoRamp[servo][0]);
    Serial.print("\t"); Serial.print(servoRamp[servo][1]);
    Serial.print("\t"); Serial.print(servoRamp[servo][2]);
    Serial.print("\t"); Serial.print(servoRamp[servo][3]);
    Serial.print("\t"); Serial.print(servoRamp[servo][4]);
    Serial.print("\t"); Serial.print(servoRamp[servo][5]);
    Serial.print("\t"); Serial.print(servoRamp[servo][6]);
    Serial.print("\t"); Serial.println(servoRamp[servo][7]);
    Serial.println();
  }
}

void go_home() {
  for (int i = 0; i < TOTAL_SERVOS; i++) {
    activeServo[i] = 0;
    activeSweep[i] = 0;
    servoSpeed[i] = spd;
    servoPos[i] = servoHome[i];
    targetPos[i] = servoHome[i];
    if (servoSetup[i][0] == 1) {
      pwm1.setPWM(servoSetup[i][1], 0, servoHome[i]);
    }
    delay(20);
  }

  for (int i = 0; i < TOTAL_LEGS; i++) {
    servoSequence[i] = 0;
  }
}

// Fast sequential carpet relief homing: centers all legs on ground first, then crisp low-lift tap relieves carpet friction
void fast_home_carpet() {
  set_stop_active();
  set_stop();

  // Phase 0: Gently command all 4 legs to home on the ground first so the body is fully supported & centered
  for (int i = 0; i < TOTAL_SERVOS; i++) {
    if (servoSetup[i][0] == 1) {
      pwm1.setPWM(servoSetup[i][1], 0, (int)servoHome[i]);
    }
  }
  delay(120);

  // Phase 1-3: Fast, low-clearance carpet tap (RF -> LR -> LF -> RR)
  // Low lift (~8mm) and quick ~120ms timing prevent any corner tipping while freeing carpet pile tension
  int leg_order[TOTAL_LEGS] = {RF, LR, LF, RR};
  int lift_t = 35;  // Low, crisp ~8mm lift to unhook carpet pile without losing balance
  int lift_f = 10;  // Gentle thigh clearance

  for (int l = 0; l < TOTAL_LEGS; l++) {
    int leg = leg_order[l];
    int c_servo = servoLeg[leg][0];
    int f_servo = servoLeg[leg][1];
    int t_servo = servoLeg[leg][2];

    float lifted_tibia = servoHome[t_servo];
    float lifted_femur = servoHome[f_servo];

    if (leg == RF || leg == RR) {
      lifted_tibia += lift_t;  // right tibia retracts upward (+PWM)
      lifted_femur -= lift_f;  // right femur lifts upward (-PWM)
    } else {
      lifted_tibia -= lift_t;  // left tibia retracts upward (-PWM)
      lifted_femur += lift_f;  // left femur lifts upward (+PWM)
    }

    // Safety clamp within servo hardware limits
    float min_t = min(servoLimit[t_servo][0], servoLimit[t_servo][1]);
    float max_t = max(servoLimit[t_servo][0], servoLimit[t_servo][1]);
    lifted_tibia = constrain(lifted_tibia, min_t, max_t);

    float min_f = min(servoLimit[f_servo][0], servoLimit[f_servo][1]);
    float max_f = max(servoLimit[f_servo][0], servoLimit[f_servo][1]);
    lifted_femur = constrain(lifted_femur, min_f, max_f);

    // Fast Step 1: Quick unweight/tap off the carpet
    pwm1.setPWM(servoSetup[t_servo][1], 0, (int)lifted_tibia);
    pwm1.setPWM(servoSetup[f_servo][1], 0, (int)lifted_femur);
    delay(35);

    // Fast Step 2: Snap coax and femur to exact servoHome with zero carpet resistance
    pwm1.setPWM(servoSetup[c_servo][1], 0, (int)servoHome[c_servo]);
    pwm1.setPWM(servoSetup[f_servo][1], 0, (int)servoHome[f_servo]);
    delay(45);

    // Fast Step 3: Plant tibia cleanly straight down to carpet
    pwm1.setPWM(servoSetup[t_servo][1], 0, (int)servoHome[t_servo]);
    delay(40);

    // Update tracked positions
    servoPos[c_servo] = servoHome[c_servo];
    servoPos[f_servo] = servoHome[f_servo];
    servoPos[t_servo] = servoHome[t_servo];
    targetPos[c_servo] = servoHome[c_servo];
    targetPos[f_servo] = servoHome[f_servo];
    targetPos[t_servo] = servoHome[t_servo];
  }

  // Ensure all servos are marked settled at home
  for (int i = 0; i < TOTAL_SERVOS; i++) {
    activeServo[i] = 0;
    activeSweep[i] = 0;
    servoSpeed[i] = spd;
    servoPos[i] = servoHome[i];
    targetPos[i] = servoHome[i];
  }
  for (int l = 0; l < TOTAL_LEGS; l++) {
    servoSequence[l] = 0;
  }
  activeGaitPair = 0;
}

void set_home() {
  for (int m = 0; m < TOTAL_SERVOS; m++) {
    activeServo[m] = 1;
    targetPos[m] = servoHome[m];
  }
}

void set_stop() {
  if (spd_lock) {
    spd = spd_lock;
    spd_lock = 0;
    set_speed();
  }
  if (step_lock) {
    move_steps = step_lock;
    step_lock = 0;
  }

  for (int m = 0; m < TOTAL_SERVOS; m++) {
    activeServo[m] = 0;
    activeSweep[m] = 0;
  }
  for (int l = 0; l < TOTAL_LEGS; l++) {
    servoSequence[l] = 0;
  }
  activeGaitPair = 0;
  set_home();
}

void set_stop_active() {
  for (int m = 0; m < TOTAL_SERVOS; m++) {
    activeServo[m] = 0;
    activeSweep[m] = 0;
  }
  for (int l = 0; l < TOTAL_LEGS; l++) {
    servoSequence[l] = 0;
  }
  activeGaitPair = 0;
  use_ramp = 0;

  moving = 0;
  move_y_axis = 0;
  move_x_axis = 0;
  move_roll = 0;
  move_roll_body = 0;
  move_pitch = 0;
  move_pitch_body = 0;
  move_trot = 0;
  move_forward = 0;
  move_backward = 0;
  move_left = 0;
  move_right = 0;
  move_march = 0;
  move_wake = 0;
  move_sequence = 0;
  move_demo = 0;
  move_wman = 0;
  move_funplay = 0;
  move_look_left = 0;
  move_look_right = 0;
  move_roll_x = 0;
  move_pitch_y = 0;
  move_kin_x = 0;
  move_kin_y = 0;
  move_yaw_x = 0;
  move_yaw_y = 0;
  move_yaw = 0;
  move_servo = 0;
  move_leg = 0;
  move_follow = 0;
}

void set_speed() {
  for (int i = 0; i < TOTAL_SERVOS; i++) {
    servoSpeed[i] = spd;
  }
  
  //recalc speed factor
  spd_factor = mapfloat(spd, min_spd, max_spd, min_spd_factor, max_spd_factor);
  if (rgb_active) {
    if (spd < 6) {
      rgb_request((char*)"MONOD");
    } else if (spd < 11) {
      rgb_request((char*)"MRNRE");
    } else if (spd < 21) {
      rgb_request((char*)"MPNPF");
    } else if (spd < 31) {
      rgb_request((char*)"MQNQG");
    } else {
      rgb_request((char*)"MSNSH");
    }
    rgb_request((char*)"xn");
  }
}



/*
   -------------------------------------------------------
   Move Functions
   -------------------------------------------------------
*/
//set pitch and roll axis from mpu data to dynamically level robot in stay/standing mode
void set_axis(float roll_step, float pitch_step) {
  // Ignore tiny movements (< 1.5 deg) so servos don't twitch at rest
  if (abs(roll_step) < 1.5) roll_step = 0.0;
  if (abs(pitch_step) < 1.5) pitch_step = 0.0;

  // Clamp max correction to prevent over-driving servos
  roll_step = constrain(roll_step, -25.0, 25.0);
  pitch_step = constrain(pitch_step, -25.0, 25.0);

  // If level, smoothly return to home if previously tilted
  if (roll_step == 0.0 && pitch_step == 0.0) {
    if (mroll_prev != 0.0 || mpitch_prev != 0.0) {
      mroll_prev = 0.0;
      mpitch_prev = 0.0;
      for (int i = 0; i < TOTAL_SERVOS; i++) {
        if (is_tibia(i) || is_femur(i)) {
          activeServo[i] = 1;
          servoSpeed[i] = (6 * spd_factor);
          targetPos[i] = servoHome[i];
        }
      }
    }
    return;
  }

  // If change from previous update is very small (< 0.5 deg), avoid redundant servo writes
  if (abs(roll_step - mroll_prev) < 0.5 && abs(pitch_step - mpitch_prev) < 0.5) {
    return;
  }
  mroll_prev = roll_step;
  mpitch_prev = pitch_step;

  for (int i = 0; i < TOTAL_SERVOS; i++) {
    float t = 0.0;
    float f = 0.0;
    if (is_tibia(i)) {
      t = servoHome[i];
    } else if (is_femur(i)) {
      f = servoHome[i];
    } else {
      continue; // Skip coaxes
    }

    // Roll correction
    if (roll_step != 0.0) {
      if (roll_step < 0) { // Roll left -> left side needs to extend, right side retract
        if (is_tibia(i)) {
          t -= ((abs(roll_step) * 0.65) * 4);
        } else if (is_femur(i)) {
          f += ((abs(roll_step) * 0.4) * 4);
        }
      } else { // Roll right -> right side needs to extend, left side retract
        if (is_tibia(i)) {
          t += ((roll_step * 0.65) * 4);
        } else if (is_femur(i)) {
          f -= ((roll_step * 0.4) * 4);
        }
      }
    }

    // Pitch correction
    if (pitch_step != 0.0) {
      if (pitch_step < 0) { // Pitch front down -> front legs extend, rear legs retract
        if (is_tibia(i)) {
          if (is_front_leg(i)) {
            (is_left_leg(i)) ? t -= ((abs(pitch_step) * 1.15) * 3) : t += ((abs(pitch_step) * 1.15) * 3);
          } else {
            (is_left_leg(i)) ? t += ((abs(pitch_step) * 1.15) * 3) : t -= ((abs(pitch_step) * 1.15) * 3);
          }
        }
      } else { // Pitch front up -> front legs retract, rear legs extend
        if (is_tibia(i)) {
          if (is_front_leg(i)) {
            (is_left_leg(i)) ? t += ((abs(pitch_step) * 1.15) * 3) : t -= ((abs(pitch_step) * 1.15) * 3);
          } else {
            (is_left_leg(i)) ? t -= ((abs(pitch_step) * 1.15) * 3) : t += ((abs(pitch_step) * 1.15) * 3);
          }
        }
      }
    }

    if (is_tibia(i)) {
      activeServo[i] = 1;
      servoSpeed[i] = (7 * spd_factor);
      targetPos[i] = limit_target(i, t, 0);
    } else if (is_femur(i)) {
      activeServo[i] = 1;
      servoSpeed[i] = (12 * spd_factor);
      targetPos[i] = limit_target(i, f, 0);
    }
  }
}


void run_demo() {
  if (!move_delay_sequences[0] && !move_delay_sequences[9]) {
    ramp_dist = 0.2;
    ramp_spd = 0.5;
    use_ramp = 1;

    move_demo = 1;

    move_delays[0] = 300;
    move_delay_sequences[0] = 15;
    move_delays[1] = 300;
    move_delay_sequences[1] = 14;
    move_delays[2] = 1200;
    move_delay_sequences[2] = 1;
    move_delays[3] = 3000;
    move_delay_sequences[3] = 2;
    move_delays[4] = 900;
    move_delay_sequences[4] = 3;
    move_delays[5] = 900;
    move_delay_sequences[5] = 5;
    move_delays[6] = 1500;
    move_delay_sequences[6] = 6;
    move_delays[7] = 1500;
    move_delay_sequences[7] = 7;
    move_delays[8] = 1500;
    move_delay_sequences[8] = 4;
    
    move_delays[9] = 900;
    move_delay_sequences[9] = 13;

    move_delays[10] = 1500;
    move_delay_sequences[10] = 11;
    
    move_delays[11] = 1500;
    move_delay_sequences[11] = 12;

    move_delays[12] = 3000;
    move_delay_sequences[12] = 8;
    move_delays[13] = 6000;
    move_delay_sequences[13] = 9;
    move_delays[14] = 3000;
    move_delay_sequences[14] = 10;

    delay_sequences();
  }
}


void funplay() {
  //recover from sitting up
  if (!activeServo[RRC] && !activeServo[RRF] && !activeServo[RRT] && !servoSequence[RR]) {
    update_sequencer(RR, RRT, 8, servoLimit[RRT][1]-80, 1, 0);
    update_sequencer(LR, LRT, 8, servoLimit[LRT][1]+80, 1, 0);
  }
  if (!activeServo[RRC] && !activeServo[RRF] && !activeServo[RRT] && servoSequence[RR] == 1) {
    update_sequencer(RR, RRF, 6, servoPos[RRF]+30, 2, 300);
    update_sequencer(LR, LRF, 6, servoPos[LRF]-30, 2, 300);
  }
  if (!activeServo[RRC] && !activeServo[RRF] && !activeServo[RRT] && servoSequence[RR] == 2) {
///repeat/open step!
    update_sequencer(RR, RRT, 8, servoLimit[RRT][1]-80, 3, 0);
    update_sequencer(LR, LRT, 8, servoLimit[LRT][1]+80, 3, 0);
  }

  if (!activeServo[RRC] && !activeServo[RRF] && !activeServo[RRT] && servoSequence[RR] == 3) {
    update_sequencer(RR, RRT, 12, servoLimit[RRT][0], 4, 50);
    update_sequencer(LR, LRT, 12, servoLimit[LRT][0], 4, 50);

    update_sequencer(RF, RFF, 24, servoHome[RFF], 1, 50);
    update_sequencer(LF, LFF, 24, servoHome[LFF], 1, 50);
    update_sequencer(RF, RFT, 24, servoLimit[RFT][1], 1, 50);
    update_sequencer(LF, LFT, 24, servoLimit[LFT][1], 1, 50);
  }

  if (!activeServo[RRC] && !activeServo[RRF] && !activeServo[RRT] && servoSequence[RR] == 4) {
    servoSpeed[RFF] = 3;
    servoSweep[RFF][0] = limit_target(RFF, (servoHome[RFF] + 40), 0);
    servoSweep[RFF][1] = limit_target(RFF, (servoHome[RFF] + 80), 20);
    servoSweep[RFF][2] = 0;
    servoSweep[RFF][3] = 9;
    targetPos[RFF] = servoSweep[RFF][1];
    activeSweep[RFF] = 1;

    servoSpeed[LFF] = 3;
    servoSweep[LFF][0] = limit_target(LFF, (servoHome[LFF] - 80), 20);
    servoSweep[LFF][1] = limit_target(LFF, (servoHome[LFF] - 40), 0);
    servoSweep[LFF][2] = 0;
    servoSweep[LFF][3] = 9;
    targetPos[LFF] = servoSweep[LFF][1];
    activeSweep[LFF] = 1;

    servoSpeed[RFT] = 5;
    servoSweep[RFT][0] = servoLimit[RFT][1];
    servoSweep[RFT][1] = servoHome[RFT];
    servoSweep[RFT][2] = 0;
    servoSweep[RFT][3] = 4;
    targetPos[RFT] = servoSweep[RFT][1];
    activeSweep[RFT] = 1;

    servoSpeed[LFT] = 5;
    servoSweep[LFT][0] = servoHome[LFT];
    servoSweep[LFT][1] = servoLimit[LFT][1];
    servoSweep[LFT][2] = 0;
    servoSweep[LFT][3] = 4;
    targetPos[LFT] = servoSweep[LFT][1];
    activeSweep[LFT] = 1;

    update_sequencer(RR, RRC, 3, servoPos[RRC], 5, 0);
  }

  if (!activeServo[RRC] && !activeServo[RRF] && !activeServo[RRT] && servoSequence[RR] == 5 && !activeSweep[RFT] && !activeSweep[LFT]) {
    update_sequencer(RF, RFT, 12, servoHome[RFT], 2, 50);
    update_sequencer(LF, LFT, 12, servoHome[LFT], 2, 50);
    update_sequencer(RR, RRT, 12, servoHome[RRT], 6, 100);
    update_sequencer(LR, LRT, 12, servoHome[LRT], 6, 100);
    update_sequencer(RR, RRF, 12, servoPos[RRF]-10, 6, 0);
    update_sequencer(LR, LRF, 12, servoPos[LRF]+10, 6, 0);

    update_sequencer(RF, RFF, 6, servoLimit[RFF][1], 2, 200);
    update_sequencer(LF, LFF, 6, servoLimit[LFF][1], 2, 200);
  }

  if (!activeServo[RFC] && !activeServo[RFF] && !activeServo[RFT] && servoSequence[RF] == 2) {
    update_sequencer(RF, RFC, 12, servoHome[RFC], 3, 0);
    update_sequencer(RR, RRF, 12, servoPos[RRF]+20, 7, 0);
    update_sequencer(LR, LRF, 12, servoPos[LRF]-20, 7, 0);
  }

  if (!activeServo[RFC] && !activeServo[RFF] && !activeServo[RFT] && servoSequence[RF] == 3 && !activeServo[RRF] && !activeServo[LRF]) {
    update_sequencer(RR, RRT, 6, servoLimit[RRT][1], 8, 50);
    update_sequencer(LR, LRT, 6, servoLimit[LRT][1], 8, 50);
    update_sequencer(RF, RFF, 12, servoHome[RFF]+30, 4, 100);
    update_sequencer(LF, LFF, 12, servoHome[LFF]-30, 4, 100);
  }

  if (!activeServo[RFC] && !activeServo[RFF] && !activeServo[RFT] && servoSequence[RF] == 4 && !activeServo[RRF] && !activeServo[LRF]) {
    update_sequencer(RF, RFC, 12, servoHome[RFC], 5, 0);
    update_sequencer(RR, RRT, 6, servoLimit[RRT][1], 9, 50);
    update_sequencer(LR, LRT, 6, servoLimit[LRT][1], 9, 50);
    update_sequencer(RR, RRF, 12, servoHome[RRF]-30, 9, 100);
    update_sequencer(LR, LRF, 12, servoHome[LRF]+30, 9, 100);
  }

  if (!activeServo[RFC] && !activeServo[RFF] && !activeServo[RFT] && servoSequence[RF] == 5 && !activeServo[RRF] && !activeServo[LRF]) {
    update_sequencer(RR, RRT, 6, servoHome[RRT], 10, 0);
    update_sequencer(LR, LRT, 6, servoHome[LRT], 10, 0);
    update_sequencer(RF, RFT, 6, servoHome[RFT], 6, 30);
    update_sequencer(LF, LFT, 6, servoHome[LFT], 6, 30);
    update_sequencer(RR, RRF, 6, servoHome[RRF], 9, 100);
    update_sequencer(LR, LRF, 6, servoHome[LRF], 9, 100);
    update_sequencer(RF, RFF, 6, servoHome[RFF], 6, 130);
    update_sequencer(LF, LFF, 6, servoHome[LFF], 6, 130);
  }

  if (!activeServo[RFC] && !activeServo[RFF] && !activeServo[RFT] && servoSequence[RF] == 6) {
    lastMoveDelayUpdate = millis();  

    if (rgb_active) {
      rgb_request((char*)"Gm");
    }
    move_funplay = 0;
    set_stop_active();
    delay(3000);
  }

}




/*
   -------------------------------------------------------
   Position Functions
   -------------------------------------------------------
*/
void set_stay() {
  for (int m = 0; m < TOTAL_SERVOS; m++) {
    activeSweep[m] = 0;
    activeServo[m] = 1;
    targetPos[m] = servoHome[m];
    servoSpeed[m] = 10;
    if (is_tibia(m)) {
      servoSpeed[m] = 5;
    }
  }

  lastMoveDelayUpdate = millis();
}

void set_sit() {
  for (int l = 0; l < TOTAL_LEGS; l++) {
    servoSequence[l] = 0;
  }
  activeGaitPair = 0;

  // Servo 0: RFC: 390.00
  activeServo[RFC] = 1;
  servoSpeed[RFC] = 10;
  targetPos[RFC] = 390.00;

  // Servo 1: RFF: 290.00
  activeServo[RFF] = 1;
  servoSpeed[RFF] = 10;
  targetPos[RFF] = 290.00;

  // Servo 2: RFT: 480.00
  activeServo[RFT] = 1;
  servoSpeed[RFT] = 10;
  targetPos[RFT] = 480.00;

  // Servo 3: LFC: 390.00
  activeServo[LFC] = 1;
  servoSpeed[LFC] = 10;
  targetPos[LFC] = 390.00;

  // Servo 4: LFF: 510.00
  activeServo[LFF] = 1;
  servoSpeed[LFF] = 10;
  targetPos[LFF] = 510.00;

  // Servo 5: LFT: 340.00
  activeServo[LFT] = 1;
  servoSpeed[LFT] = 10;
  targetPos[LFT] = 340.00;

  // Servo 6: RRC: 420.00
  activeServo[RRC] = 1;
  servoSpeed[RRC] = 10;
  targetPos[RRC] = 420.00;

  // Servo 7: RRF: 210.00
  activeServo[RRF] = 1;
  servoSpeed[RRF] = 10;
  targetPos[RRF] = 210.00;

  // Servo 8: RRT: 630.00
  activeServo[RRT] = 1;
  servoSpeed[RRT] = 10;
  targetPos[RRT] = 630.00;

  // Servo 9: LRC: 400.00
  activeServo[LRC] = 1;
  servoSpeed[LRC] = 10;
  targetPos[LRC] = 400.00;

  // Servo 10: LRF: 540.00
  activeServo[LRF] = 1;
  servoSpeed[LRF] = 10;
  targetPos[LRF] = 540.00;

  // Servo 11: LRT: 160.00
  activeServo[LRT] = 1;
  servoSpeed[LRT] = 10;
  targetPos[LRT] = 160.00;

  lastMoveDelayUpdate = millis();
}

void set_crouch() {
  set_lay();
}

void set_lay() {
  for (int l = 0; l < TOTAL_LEGS; l++) {
    servoSequence[l] = 0;
  }
  activeGaitPair = 0;

  // Servo 0: RFC: 390.00
  activeServo[RFC] = 1;
  servoSpeed[RFC] = 10;
  targetPos[RFC] = 390.00;

  // Servo 1: RFF: 290.00
  activeServo[RFF] = 1;
  servoSpeed[RFF] = 10;
  targetPos[RFF] = 290.00;

  // Servo 2: RFT: 680.00
  activeServo[RFT] = 1;
  servoSpeed[RFT] = 10;
  targetPos[RFT] = 680.00;

  // Servo 3: LFC: 390.00
  activeServo[LFC] = 1;
  servoSpeed[LFC] = 10;
  targetPos[LFC] = 390.00;

  // Servo 4: LFF: 510.00
  activeServo[LFF] = 1;
  servoSpeed[LFF] = 10;
  targetPos[LFF] = 510.00;

  // Servo 5: LFT: 130.00
  activeServo[LFT] = 1;
  servoSpeed[LFT] = 10;
  targetPos[LFT] = 130.00;

  // Servo 6: RRC: 420.00
  activeServo[RRC] = 1;
  servoSpeed[RRC] = 10;
  targetPos[RRC] = 420.00;

  // Servo 7: RRF: 210.00
  activeServo[RRF] = 1;
  servoSpeed[RRF] = 10;
  targetPos[RRF] = 210.00;

  // Servo 8: RRT: 690.00
  activeServo[RRT] = 1;
  servoSpeed[RRT] = 10;
  targetPos[RRT] = 690.00;

  // Servo 9: LRC: 400.00
  activeServo[LRC] = 1;
  servoSpeed[LRC] = 10;
  targetPos[LRC] = 400.00;

  // Servo 10: LRF: 540.00
  activeServo[LRF] = 1;
  servoSpeed[LRF] = 10;
  targetPos[LRF] = 540.00;

  // Servo 11: LRT: 130.00
  activeServo[LRT] = 1;
  servoSpeed[LRT] = 10;
  targetPos[LRT] = 130.00;

  lastMoveDelayUpdate = millis();
}

void set_kneel() {
  activeServo[LFC] = 1;
  servoSpeed[LFC] = 10;
  targetPos[LFC] = (servoLimit[LFC][0] - 10);
  activeServo[LRC] = 1;
  servoSpeed[LRC] = 10;
  targetPos[LRC] = (servoLimit[LRC][0] - 10);
  activeServo[RFC] = 1;
  servoSpeed[RFC] = 10;
  targetPos[RFC] = (servoLimit[RFC][0] + 10);
  activeServo[RRC] = 1;
  servoSpeed[RRC] = 10;
  targetPos[RRC] = (servoLimit[RRC][0] + 10);

  activeServo[LFT] = 1;
  servoSpeed[LFT] = 20;
  targetPos[LFT] = (servoHome[LFT] - 40);
  activeServo[RFT] = 1;
  servoSpeed[RFT] = 20;
  targetPos[RFT] = (servoHome[RFT] + 40);

  activeServo[LRT] = 1;
  servoSpeed[LRT] = 20;
  targetPos[LRT] = (servoHome[LRT] - 40);
  activeServo[RRT] = 1;
  servoSpeed[RRT] = 20;
  targetPos[RRT] = (servoHome[RRT] + 40);

  activeServo[LRF] = 1;
  servoSpeed[LRF] = 10;
  targetPos[LRF] = (servoLimit[LRF][1] + 90);
  activeServo[RRF] = 1;
  servoSpeed[RRF] = 10;
  targetPos[RRF] = (servoLimit[RRF][1] - 90);

  activeServo[LFF] = 1;
  servoSpeed[LFF] = 10;
  targetPos[LFF] = (servoLimit[LFF][1] + 90);
  activeServo[RFF] = 1;
  servoSpeed[RFF] = 10;
  targetPos[RFF] = (servoLimit[RFF][1] - 90);

  lastMoveDelayUpdate = millis();
}


void look_left() {
  if (rgb_active) {
    rgb_request((char*)"MSNSvFn");
  }

  if (!activeServo[RFC] && !activeServo[RFF] && !activeServo[RFT] && !servoSequence[RF]) {
    update_sequencer(LF, LFT, spd, (servoHome[LFT] + move_steps), 1, 0);
    update_sequencer(LF, LFC, spd, (servoHome[LFC] + move_steps), 1, 0);
    update_sequencer(LR, LRT, spd, (servoHome[LRT] + move_steps), 1, 0);
    update_sequencer(LR, LRC, spd, (servoHome[LRC] + move_steps), 1, 0);
    update_sequencer(RR, RRT, spd, (servoHome[RRT] + move_steps), 1, 0);
    update_sequencer(RR, RRC, spd, (servoHome[RRC] + move_steps), 1, 0);
    update_sequencer(RF, RFT, spd, (servoHome[RFT] + move_steps), 1, 0);
    update_sequencer(RF, RFC, spd, (servoHome[RFC] + move_steps), 1, 0);
  }

  if (!activeServo[RFC] && !activeServo[RFF] && !activeServo[RFT] && servoSequence[RF] == 1) {
    update_sequencer(RF, RFC, spd, servoHome[RFC], 2, 1000);
  }

  if (!activeServo[RFC] && !activeServo[RFF] && !activeServo[RFT] && servoSequence[RF] == 2) {
    for (int i = 0; i < TOTAL_SERVOS; i++) {
      if (is_left_leg(i) && !is_front_leg(i)) {
        update_sequencer(LR, i, spd, servoHome[i], 3, 0);
      } else if (is_left_leg(i) && is_front_leg(i)) {
        update_sequencer(LF, i, spd, servoHome[i], 3, 0);
      } else if (!is_left_leg(i) && is_front_leg(i)) {
        update_sequencer(RF, i, spd, servoHome[i], 3, 0);
      } else {
        update_sequencer(RR, i, spd, servoHome[i], 3, 0);
      }
    }
  }
  
  if (!activeServo[RFC] && !activeServo[RFF] && !activeServo[RFT] && servoSequence[RF] == 3) {
    update_sequencer(RF, RFC, spd, servoHome[RFC], 4, 1000);
  }

  if (!activeServo[RFC] && !activeServo[RFF] && !activeServo[RFT] && servoSequence[RF] == 4) {
    for (int i = 0; i < TOTAL_LEGS; i++) {
      servoSequence[i] = 0;
    }
    
    move_look_left = 0;
    move_loops = 4;
    move_switch = 2;
    move_wake = 1;

    //if called from follow routine, restore
    if (move_paused == "follow") {
      move_follow = 1;
      spd = spd_prev;
      set_speed();
    }
  }
}

void look_right() {
  if (rgb_active) {
    rgb_request((char*)"MSNSvFn");
  }

  if (!activeServo[RFC] && !activeServo[RFF] && !activeServo[RFT] && !servoSequence[RF]) {
    update_sequencer(LF, LFT, spd, (servoHome[LFT] - move_steps), 1, 0);
    update_sequencer(LF, LFC, spd, (servoHome[LFC] - move_steps), 1, 0);
    update_sequencer(LR, LRT, spd, (servoHome[LRT] - move_steps), 1, 0);
    update_sequencer(LR, LRC, spd, (servoHome[LRC] - move_steps), 1, 0);
    update_sequencer(RR, RRT, spd, (servoHome[RRT] - move_steps), 1, 0);
    update_sequencer(RR, RRC, spd, (servoHome[RRC] - move_steps), 1, 0);
    update_sequencer(RF, RFT, spd, (servoHome[RFT] - move_steps), 1, 0);
    update_sequencer(RF, RFC, spd, (servoHome[RFC] - move_steps), 1, 0);
  }

  if (!activeServo[RFC] && !activeServo[RFF] && !activeServo[RFT] && servoSequence[RF] == 1) {
    update_sequencer(RF, RFC, spd, servoHome[RFC], 2, 1000);
  }

  if (!activeServo[RFC] && !activeServo[RFF] && !activeServo[RFT] && servoSequence[RF] == 2) {
    for (int i = 0; i < TOTAL_SERVOS; i++) {
      if (is_left_leg(i) && !is_front_leg(i)) {
        update_sequencer(LR, i, spd, servoHome[i], 3, 0);
      } else if (is_left_leg(i) && is_front_leg(i)) {
        update_sequencer(LF, i, spd, servoHome[i], 3, 0);
      } else if (!is_left_leg(i) && is_front_leg(i)) {
        update_sequencer(RF, i, spd, servoHome[i], 3, 0);
      } else {
        update_sequencer(RR, i, spd, servoHome[i], 3, 0);
      }
    }
  }
  
  if (!activeServo[RFC] && !activeServo[RFF] && !activeServo[RFT] && servoSequence[RF] == 3) {
    update_sequencer(RF, RFC, spd, servoHome[RFC], 4, 1000);
  }

  if (!activeServo[RFC] && !activeServo[RFF] && !activeServo[RFT] && servoSequence[RF] == 4) {
    for (int i = 0; i < TOTAL_LEGS; i++) {
      servoSequence[i] = 0;
    }
    
    move_look_right = 0;
    move_loops = 4;
    move_switch = 2;
    move_wake = 1;

    //if called from follow routine, restore
    if (move_paused == "follow") {
      move_follow = 1;
      spd = spd_prev;
      set_speed();
    }
  }
}



/*
   -------------------------------------------------------
   (implied) Kinematics Functions
   -------------------------------------------------------
*/

void move_kx() {
  int fms = (move_steps_kx * 0.8);
  int tms = (move_steps_kx * 1.3);
  int fsp = limit_speed((24 * spd_factor));
  int tsp = limit_speed((14 * spd_factor));

  update_sequencer(RF, RFF, fsp, (servoHome[RFF] - fms), 0, 0);
  update_sequencer(RF, RFT, tsp, (servoHome[RFT] + tms), 1, 0);
  update_sequencer(LF, LFF, fsp, (servoHome[LFF] + fms), 0, 0);
  update_sequencer(LF, LFT, tsp, (servoHome[LFT] - tms), 1, 0);

  update_sequencer(RR, RRF, fsp, (servoHome[RRF] - fms), 0, 0);
  update_sequencer(RR, RRT, tsp, (servoHome[RRT] + tms), 1, 0);
  update_sequencer(LR, LRF, fsp, (servoHome[LRF] + fms), 0, 0);
  update_sequencer(LR, LRT, tsp, (servoHome[LRT] - tms), 1, 0);

  move_kin_x = 0;

  lastMoveDelayUpdate = millis();  
}


void move_ky() {

  int fms = (move_steps_ky * 0.8);
  int tms = (move_steps_ky * 1.3);
  int fsp = limit_speed((24 * spd_factor));
  int tsp = limit_speed((14 * spd_factor));

  update_sequencer(RF, RFF, fsp, (servoHome[RFF] - fms), 0, 0);
  update_sequencer(RF, RFT, tsp, (servoHome[RFT] + tms), 1, 0);
  update_sequencer(LF, LFF, fsp, (servoHome[LFF] + fms), 0, 0);
  update_sequencer(LF, LFT, tsp, (servoHome[LFT] - tms), 1, 0);

  update_sequencer(RR, RRF, fsp, (servoHome[RRF] - fms), 0, 0);
  update_sequencer(RR, RRT, tsp, (servoHome[RRT] + tms), 1, 0);
  update_sequencer(LR, LRF, fsp, (servoHome[LRF] + fms), 0, 0);
  update_sequencer(LR, LRT, tsp, (servoHome[LRT] - tms), 1, 0);

  move_kin_y = 0;

  lastMoveDelayUpdate = millis(); 
}



void roll_x() {
  int csp = limit_speed((12 * spd_factor));

  update_sequencer(LF, LFC, csp, (servoHome[LFC] + move_steps_x), 0, 0);
  update_sequencer(LR, LRC, csp, (servoHome[LRC] + move_steps_x), 0, 0);
  update_sequencer(RF, RFC, csp, (servoHome[RFC] + move_steps_x), 0, 0);
  update_sequencer(RR, RRC, csp, (servoHome[RRC] + move_steps_x), 0, 0);

  move_roll_x = 0;

  lastMoveDelayUpdate = millis();  
}

void pitch_y() {

  int fms = (move_steps_y * 0.4);
  int tms = (move_steps_y * 0.65);
  int fsp = limit_speed((24 * spd_factor));
  int tsp = limit_speed((14 * spd_factor));

  update_sequencer(RF, RFF, fsp, (servoHome[RFF] - fms), 0, 0);
  update_sequencer(RF, RFT, tsp, (servoHome[RFT] + tms), 1, 0);
  update_sequencer(LF, LFF, fsp, (servoHome[LFF] + fms), 0, 0);
  update_sequencer(LF, LFT, tsp, (servoHome[LFT] - tms), 1, 0);

  update_sequencer(RR, RRF, fsp, (servoHome[RRF] + fms), 0, 0);
  update_sequencer(RR, RRT, tsp, (servoHome[RRT] - tms), 1, 0);
  update_sequencer(LR, LRF, fsp, (servoHome[LRF] - fms), 0, 0);
  update_sequencer(LR, LRT, tsp, (servoHome[LRT] + tms), 1, 0);

  move_pitch_y = 0;

  lastMoveDelayUpdate = millis();  
}

void yaw() {
  int cms = (move_steps_yaw * 0.4);
  int fms = (move_steps_yaw * 0.3);
  int tms = (move_steps_yaw * 0.1);
  int csp = limit_speed((10 * spd_factor));
  int fsp = limit_speed((20 * spd_factor));
  int tsp = limit_speed((40 * spd_factor));

//  int lfms = fms;
//  int rfms = fms;
  int ltms = tms;
  int rtms = tms;
  if (move_steps_yaw < 0) {
//    lfms = (move_steps_yaw * 0.5);
    ltms = (move_steps_yaw * 0.4);
  } else {
//    rfms = (move_steps_yaw * 0.5);
    rtms = (move_steps_yaw * 0.4);
  }

  int lfsp = fsp;
  int rfsp = fsp;
  int ltsp = tsp;
  int rtsp = tsp;
  if (move_steps_yaw < 0) {
    lfsp = limit_speed((8 * spd_factor));
    ltsp = limit_speed((10 * spd_factor));
  } else {
    rfsp = limit_speed((8 * spd_factor));
    rtsp = limit_speed((10 * spd_factor));
  }

  update_sequencer(LF, LFC, csp, (servoHome[LFC] + cms), 0, 0);
  update_sequencer(LF, LFF, lfsp, (servoHome[LFF] + fms), 1, 0);
  update_sequencer(LF, LFT, ltsp, (servoHome[LFT] - ltms), 1, 0);

  update_sequencer(RF, RFC, csp, (servoHome[RFC] + cms), 0, 0);
  update_sequencer(RF, RFF, rfsp, (servoHome[RFF] + fms), 1, 0);
  update_sequencer(RF, RFT, rtsp, (servoHome[RFT] - rtms), 1, 0);

  update_sequencer(LR, LRC, csp, (servoHome[LRC] - cms), 0, 0);
  update_sequencer(LR, LRF, lfsp, (servoHome[LRF] - fms), 1, 0);
  update_sequencer(LR, LRT, ltsp, (servoHome[LRT] + ltms), 1, 0);

  update_sequencer(RR, RRC, csp, (servoHome[RRC] - cms), 0, 0);
  update_sequencer(RR, RRF, rfsp, (servoHome[RRF] - fms), 1, 0);
  update_sequencer(RR, RRT, rtsp, (servoHome[RRT] + rtms), 1, 0);

  move_yaw = 0;

  lastMoveDelayUpdate = millis();  
}

void yaw_x() {
  int cms = (move_steps_yaw_x * 0.9);
  int fms = (move_steps_yaw_x * 0.4);
  int tms = (move_steps_yaw_x * 0.7);
  int csp = limit_speed((20 * spd_factor));
  int fsp = limit_speed((32 * spd_factor));
  int tsp = limit_speed((20 * spd_factor));

  update_sequencer(LF, LFC, csp, (servoHome[LFC] + cms), 0, 0);
  update_sequencer(LF, LFF, fsp, (servoHome[LFF] + fms), 1, 0);
  update_sequencer(LF, LFT, tsp, (servoHome[LFT] - tms), 1, 0);

  update_sequencer(LR, LRC, csp, (servoHome[LRC] + cms), 0, 0);
  update_sequencer(LR, LRF, fsp, (servoHome[LRF] + fms), 1, 0);
  update_sequencer(LR, LRT, tsp, (servoHome[LRT] - tms), 1, 0);

  update_sequencer(RF, RFC, csp, (servoHome[RFC] + cms), 0, 0);
  update_sequencer(RF, RFF, fsp, (servoHome[RFF] + fms), 1, 0);
  update_sequencer(RF, RFT, tsp, (servoHome[RFT] - tms), 1, 0);

  update_sequencer(RR, RRC, csp, (servoHome[RRC] + cms), 0, 0);
  update_sequencer(RR, RRF, fsp, (servoHome[RRF] + fms), 1, 0);
  update_sequencer(RR, RRT, tsp, (servoHome[RRT] - tms), 1, 0);

  move_yaw_x = 0;

  lastMoveDelayUpdate = millis();  
}

void yaw_y() {

  int fms = (move_steps_yaw_y * 0.6);
  int tms = (move_steps_yaw_y * 0.2);
  int fsp = limit_speed((25 * spd_factor));
  int tsp = limit_speed((30 * spd_factor));

  int ftms = tms;
  if (move_steps_yaw_y > 0) {
    fms = (move_steps_yaw_y * 0.3);
    tms = (move_steps_yaw_y * 0.1);
    ftms = (move_steps_yaw_y * 0.2);
  }

  update_sequencer(RF, RFF, fsp, (servoHome[RFF] - fms), 0, 0);
  update_sequencer(RF, RFT, tsp, (servoHome[RFT] - ftms), 1, 0);
  update_sequencer(LF, LFF, fsp, (servoHome[LFF] + fms), 0, 0);
  update_sequencer(LF, LFT, tsp, (servoHome[LFT] + ftms), 1, 0);

  update_sequencer(RR, RRF, fsp, (servoHome[RRF] - fms), 0, 0);
  update_sequencer(RR, RRT, tsp, (servoHome[RRT] - tms), 1, 0);
  update_sequencer(LR, LRF, fsp, (servoHome[LRF] + fms), 0, 0);
  update_sequencer(LR, LRT, tsp, (servoHome[LRT] + tms), 1, 0);

  move_yaw_y = 0;

  lastMoveDelayUpdate = millis();  
}

void x_axis() {
  if (!activeSweep[RRT]) {
    servoSpeed[LFF] = limit_speed((10 * spd_factor));
    servoSweep[LFF][0] = limit_target(LFF, ((servoHome[LFF] - 70) + (move_steps * .7)), 0);
    servoSweep[LFF][1] = limit_target(LFF, ((servoHome[LFF] - 10) + (move_steps * .1)), 0);
    servoSweep[LFF][2] = 0;
    servoSweep[LFF][3] = 1;
    targetPos[LFF] = servoSweep[LFF][1];
    activeSweep[LFF] = 1;

    servoSpeed[LFT] = limit_speed((10 * spd_factor));
    servoSweep[LFT][0] = limit_target(LFT, ((servoHome[LFT] + 85) - (move_steps * .85)), 0);
    servoSweep[LFT][1] = limit_target(LFT, ((servoHome[LFT] + 25) - (move_steps * .25)), 0);
    servoSweep[LFT][2] = 0;
    servoSweep[LFT][3] = 1;
    targetPos[LFT] = servoSweep[LFT][1];
    activeSweep[LFT] = 1;


    servoSpeed[RFF] = limit_speed((10 * spd_factor));
    servoSweep[RFF][0] = limit_target(RFF, ((servoHome[RFF] + 70) - (move_steps * .7)), 0); //65
    servoSweep[RFF][1] = limit_target(RFF, ((servoHome[RFF] + 10) - (move_steps * .1)), 0); //5
    servoSweep[RFF][2] = 0;
    servoSweep[RFF][3] = 1;
    targetPos[RFF] = servoSweep[RFF][1];
    activeSweep[RFF] = 1;

    servoSpeed[RFT] = limit_speed((10 * spd_factor));
    servoSweep[RFT][0] = limit_target(RFT, ((servoHome[RFT] - 85) + (move_steps * .85)), 0);
    servoSweep[RFT][1] = limit_target(RFT, ((servoHome[RFT] - 25) + (move_steps * .25)), 0);
    servoSweep[RFT][2] = 0;
    servoSweep[RFT][3] = 1;
    targetPos[RFT] = servoSweep[RFT][1];
    activeSweep[RFT] = 1;


    servoSpeed[LRF] = limit_speed((10 * spd_factor));
    servoSweep[LRF][0] = limit_target(LRF, ((servoHome[LRF] - 70) + (move_steps * .7)), 0);
    servoSweep[LRF][1] = limit_target(LRF, ((servoHome[LRF] - 10) + (move_steps * .1)), 0);
    servoSweep[LRF][2] = 0;
    servoSweep[LRF][3] = 1;
    targetPos[LRF] = servoSweep[LRF][1];
    activeSweep[LRF] = 1;

    servoSpeed[LRT] = limit_speed((10 * spd_factor));
    servoSweep[LRT][0] = limit_target(LRT, ((servoHome[LRT] + 85) - (move_steps * .85)), 0); //90
    servoSweep[LRT][1] = limit_target(LRT, ((servoHome[LRT] + 25) - (move_steps * .25)), 0); //30
    servoSweep[LRT][2] = 0;
    servoSweep[LRT][3] = 1;
    targetPos[LRT] = servoSweep[LRT][1];
    activeSweep[LRT] = 1;


    servoSpeed[RRF] = limit_speed((10 * spd_factor));
    servoSweep[RRF][0] = limit_target(RRF, ((servoHome[RRF] + 70) - (move_steps * .7)), 0);
    servoSweep[RRF][1] = limit_target(RRF, ((servoHome[RRF] + 10) - (move_steps * .1)), 0);
    servoSweep[RRF][2] = 0;
    servoSweep[RRF][3] = 1;
    targetPos[RRF] = servoSweep[RRF][1];
    activeSweep[RRF] = 1;

    servoSpeed[RRT] = limit_speed((10 * spd_factor));
    servoSweep[RRT][0] = limit_target(RRT, ((servoHome[RRT] - 85) + (move_steps * .85)), 0);
    servoSweep[RRT][1] = limit_target(RRT, ((servoHome[RRT] - 25) + (move_steps * .25)), 0);
    servoSweep[RRT][2] = 0;
    servoSweep[RRT][3] = 1;
    targetPos[RRT] = servoSweep[RRT][1];
    activeSweep[RRT] = 1;

    if (move_loops) {
      move_loops--;
      if (!move_loops) {
        move_x_axis = 0;
      }
    }

    lastMoveDelayUpdate = millis();  
  }
}

void y_axis() {

  if (!activeSweep[RRT]) {
    servoSpeed[LFC] = limit_speed((96 * spd_factor));
    servoSweep[LFC][0] = (servoHome[LFC]);
    servoSweep[LFC][1] = limit_target(LFC, (servoHome[LFC] + (move_steps * .05)), 0);
    servoSweep[LFC][2] = 0;
    servoSweep[LFC][3] = 1;
    targetPos[LFC] = servoSweep[LFC][1];
    activeSweep[LFC] = 1;

    servoSpeed[LFT] = limit_speed((7 * spd_factor));
    servoSweep[LFT][0] = limit_target(LFT, (servoHome[LFT] - (move_steps * .65)), 0);
    servoSweep[LFT][1] = limit_target(LFT, (servoHome[LFT] + (move_steps * .65)), 0);
    servoSweep[LFT][2] = 0;
    servoSweep[LFT][3] = 1;
    targetPos[LFT] = servoSweep[LFT][1];
    activeSweep[LFT] = 1;

    servoSpeed[LFF] = limit_speed((12 * spd_factor));
    servoSweep[LFF][0] = limit_target(LFF, (servoHome[LFF] + (move_steps * .4)), 0);
    servoSweep[LFF][1] = limit_target(LFF, (servoHome[LFF] - (move_steps * .4)), 0);
    servoSweep[LFF][2] = 0;
    servoSweep[LFF][3] = 1;
    targetPos[LFF] = servoSweep[LFF][1];
    activeSweep[LFF] = 1;


    servoSpeed[RFC] = limit_speed((96 * spd_factor));
    servoSweep[RFC][0] = (servoHome[RFC]);
    servoSweep[RFC][1] = limit_target(RFC, (servoHome[RFC] - (move_steps * .05)), 0);
    servoSweep[RFC][2] = 0;
    servoSweep[RFC][3] = 1;
    targetPos[RFC] = servoSweep[RFC][1];
    activeSweep[RFC] = 1;

    servoSpeed[RFT] = limit_speed((7 * spd_factor));
    servoSweep[RFT][0] = limit_target(RFT, (servoHome[RFT] + (move_steps * .65)), 0);
    servoSweep[RFT][1] = limit_target(RFT, (servoHome[RFT] - (move_steps * .65)), 0);
    servoSweep[RFT][2] = 0;
    servoSweep[RFT][3] = 1;
    targetPos[RFT] = servoSweep[RFT][1];
    activeSweep[RFT] = 1;

    servoSpeed[RFF] = limit_speed((12 * spd_factor));
    servoSweep[RFF][0] = limit_target(RFF, (servoHome[RFF] - (move_steps * .4)), 0);
    servoSweep[RFF][1] = limit_target(RFF, (servoHome[RFF] + (move_steps * .4)), 0);
    servoSweep[RFF][2] = 0;
    servoSweep[RFF][3] = 1;
    targetPos[RFF] = servoSweep[RFF][1];
    activeSweep[RFF] = 1;


    servoSpeed[LRC] = limit_speed((96 * spd_factor));
    servoSweep[LRC][0] = (servoHome[LRC]);
    servoSweep[LRC][1] = limit_target(LRC, (servoHome[LRC] + (move_steps * .05)), 0);
    servoSweep[LRC][2] = 0;
    servoSweep[LRC][3] = 1;
    targetPos[LRC] = servoSweep[LRC][1];
    activeSweep[LRC] = 1;

    servoSpeed[LRT] = limit_speed((7 * spd_factor));
    servoSweep[LRT][0] = limit_target(LRT, (servoHome[LRT] - (move_steps * .65)), 0);
    servoSweep[LRT][1] = limit_target(LRT, (servoHome[LRT] + (move_steps * .65)), 0);
    servoSweep[LRT][2] = 0;
    servoSweep[LRT][3] = 1;
    targetPos[LRT] = servoSweep[LRT][1];
    activeSweep[LRT] = 1;

    servoSpeed[LRF] = limit_speed((12 * spd_factor));
    servoSweep[LRF][0] = limit_target(LRF, (servoHome[LRF] + (move_steps * .4)), 0);
    servoSweep[LRF][1] = limit_target(LRF, (servoHome[LRF] - (move_steps * .4)), 0);
    servoSweep[LRF][2] = 0;
    servoSweep[LRF][3] = 1;
    targetPos[LRF] = servoSweep[LRF][1];
    activeSweep[LRF] = 1;


    servoSpeed[RRC] = limit_speed((96 * spd_factor));
    servoSweep[RRC][0] = (servoHome[RRC]);
    servoSweep[RRC][1] = limit_target(RRC, (servoHome[RRC] - (move_steps * .05)), 0);
    servoSweep[RRC][2] = 0;
    servoSweep[RRC][3] = 1;
    targetPos[RRC] = servoSweep[RRC][1];
    activeSweep[RRC] = 1;

    servoSpeed[RRT] = limit_speed((7 * spd_factor));
    servoSweep[RRT][0] = limit_target(RRT, (servoHome[RRT] + (move_steps * .65)), 0);
    servoSweep[RRT][1] = limit_target(RRT, (servoHome[RRT] - (move_steps * .65)), 0);
    servoSweep[RRT][2] = 0;
    servoSweep[RRT][3] = 1;
    targetPos[RRT] = servoSweep[RRT][1];
    activeSweep[RRT] = 1;

    servoSpeed[RRF] = limit_speed((12 * spd_factor));
    servoSweep[RRF][0] = limit_target(RRF, (servoHome[RRF] - (move_steps * .4)), 0);
    servoSweep[RRF][1] = limit_target(RRF, (servoHome[RRF] + (move_steps * .4)), 0);
    servoSweep[RRF][2] = 0;
    servoSweep[RRF][3] = 1;
    targetPos[RRF] = servoSweep[RRF][1];
    activeSweep[RRF] = 1;

    if (move_loops) {
      move_loops--;
      if (!move_loops) {
        move_y_axis = 0;
      }
    }
  
    lastMoveDelayUpdate = millis();  
  }
}

void roll() {
  if (!activeSweep[RRF]) {
    servoSpeed[LFT] = limit_speed((5 * spd_factor));
    servoSweep[LFT][0] = limit_target(LFT, (servoHome[LFT] - move_steps), 0);
    servoSweep[LFT][1] = limit_target(LFT, (servoHome[LFT] + move_steps), 0);
    servoSweep[LFT][2] = 0;
    servoSweep[LFT][3] = 1;
    targetPos[LFT] = servoSweep[LFT][1];
    activeSweep[LFT] = 1;

    servoSpeed[LFF] = limit_speed((8 * spd_factor));
    servoSweep[LFF][0] = limit_target(LFF, (servoHome[LFF] + (move_steps * .667)), 0);
    servoSweep[LFF][1] = limit_target(LFF, (servoHome[LFF] - (move_steps * .667)), 0);
    servoSweep[LFF][2] = 0;
    servoSweep[LFF][3] = 1;
    targetPos[LFF] = servoSweep[LFF][1];
    activeSweep[LFF] = 1;


    servoSpeed[LRT] = limit_speed((5 * spd_factor));
    servoSweep[LRT][0] = limit_target(LRT, (servoHome[LRT] - move_steps), 0);
    servoSweep[LRT][1] = limit_target(LRT, (servoHome[LRT] + move_steps), 0);
    servoSweep[LRT][2] = 0;
    servoSweep[LRT][3] = 1;
    targetPos[LRT] = servoSweep[LRT][1];
    activeSweep[LRT] = 1;

    servoSpeed[LRF] = limit_speed((8 * spd_factor));
    servoSweep[LRF][0] = limit_target(LRF, (servoHome[LRF] + (move_steps * .667)), 0);
    servoSweep[LRF][1] = limit_target(LRF, (servoHome[LRF] - (move_steps * .667)), 0);
    servoSweep[LRF][2] = 0;
    servoSweep[LRF][3] = 1;
    targetPos[LRF] = servoSweep[LRF][1];
    activeSweep[LRF] = 1;


    servoSpeed[RFT] = limit_speed((5 * spd_factor));
    servoSweep[RFT][0] = limit_target(RFT, (servoHome[RFT] - move_steps), 0);
    servoSweep[RFT][1] = limit_target(RFT, (servoHome[RFT] + move_steps), 0);
    servoSweep[RFT][2] = 0;
    servoSweep[RFT][3] = 1;
    targetPos[RFT] = servoSweep[RFT][1];
    activeSweep[RFT] = 1;

    servoSpeed[RFF] = limit_speed((8 * spd_factor));
    servoSweep[RFF][0] = limit_target(RFF, (servoHome[RFF] + (move_steps * .667)), 0);
    servoSweep[RFF][1] = limit_target(RFF, (servoHome[RFF] - (move_steps * .667)), 0);
    servoSweep[RFF][2] = 0;
    servoSweep[RFF][3] = 1;
    targetPos[RFF] = servoSweep[RFF][1];
    activeSweep[RFF] = 1;


    servoSpeed[RRT] = limit_speed((5 * spd_factor));
    servoSweep[RRT][0] = limit_target(RRT, (servoHome[RRT] - move_steps), 0);
    servoSweep[RRT][1] = limit_target(RRT, (servoHome[RRT] + move_steps), 0);
    servoSweep[RRT][2] = 0;
    servoSweep[RRT][3] = 1;
    targetPos[RRT] = servoSweep[RRT][1];
    activeSweep[RRT] = 1;

    servoSpeed[RRF] = limit_speed((8 * spd_factor));
    servoSweep[RRF][0] = limit_target(RRF, (servoHome[RRF] + (move_steps * .667)), 0);
    servoSweep[RRF][1] = limit_target(RRF, (servoHome[RRF] - (move_steps * .667)), 0);
    servoSweep[RRF][2] = 0;
    servoSweep[RRF][3] = 1;
    targetPos[RRF] = servoSweep[RRF][1];
    activeSweep[RRF] = 1;

    if (move_loops) {
      move_loops--;
      if (!move_loops) {
        move_roll = 0;
      }
    }

    lastMoveDelayUpdate = millis();  
  }
}
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
