Hampterz/novacode/(commit log)

2026-08-16 fix: enable slave_active for USS sensors
    Issue: Ultrasonic sensors always reading 0 cm on both left and right.
    Serial output showed 'USS RAW -> Left: 0 cm | Right: 0 cm' repeatedly.
    Root cause: slave_active was set to 0, but the USS sensors are physically
    connected to the Nano slave board. The uss_check() function calls
    command_slave('a') and command_slave('b') to read distances over I2C,
    but command_slave() gates ALL communication behind 'if(commands && slave_active)',
    so with slave_active=0 it immediately returns 0 without ever talking to the Nano.
    Fix: Set slave_active = 1 so the Teensy can communicate with the Nano
    slave over I2C to read the ultrasonic sensor data.
    Also includes: upda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
    [Nova-SM3-calibrate.ino, Nova-SM3_teensyNRF-v5.2b_mp3_pro.ino, NovaServos.h]
2026-08-16 Fix controller button mappings and mode freeze bug
    [AsyncServo.h, Nova-SM3_teensyNRF-v5.2b_mp3_pro.ino, NovaServos.h, OLED_Test.ino, nova_controller.py, nova_serial_transmitter.ino, novaserialtrasmitter.ino]
2026-08-16 fix: resolve random mode shifting and freezing due to serial corruption and misaligned button mappings
    Reverted button array mapping in novaserialtrasmitter.ino to its original, correct state. Added robust comma-counting validation to parse_command() to drop incomplete serial packets. Lowered Python transmit rate to 20Hz to prevent Arduino serial buffer overflow.
    [novaserialtrasmitter.ino]
2026-08-16 fix: mode corruption, inverted walking, disconnect failsafe, USS spam
    Root cause: Nano legacy command handler treated corrupted serial fragments as mode-change commands. A packet split at a bad boundary (missing '<') would fall through to handle_command_legacy(), randomly setting sel1=1 or changing p1, which caused the Teensy to cycle modes unexpectedly.
    Changes:
    - Nano: Only accept short non-packet strings (<=4 chars, no commas) as legacy commands. Corrupted fragments are silently dropped.
    - Nano: Added comma-count validation to parse_command() to reject incomplete packets.
    - Teensy: Moved lastNRFUpdate=millis() INSIDE the nrf_radio.available() block so disconnect detection actually wor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
    [Nova-SM3_teensyNRF-v5.2b_mp3_pro.ino, nova_controller.py, novaserialtrasmitter.ino]
2026-08-16 fix: Nano heap memory corruption and Teensy boot tilt
    Root cause: The Nano transmitter used the Arduino String class to parse 12 substrings per packet at 20Hz. This completely fragmented the Nano's 2KB heap within seconds. Once fragmented, String operations returned pointers to old data, causing random mode switches (e.g. freestyle mode) when pressing unrelated keys.
    Root cause 2: The Nano initialized joystick values to 0. When the Teensy booted before the Python controller connected, the Nano failsafe transmitted the 0s. The Teensy mapped this to maximum negative joystick travel, causing the robot to violently tilt and try to walk.
    - Nano: Rewrote parse_command and loop to use C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
    [novaserialtrasmitter.ino]
2026-08-16 fix: compiler syntax errors in Nano parser rewrite
    Fixed missing closing brace and mismatched signatures that broke Arduino IDE's prototype generator, and explicitly added function prototypes.
    [novaserialtrasmitter.ino]
2026-08-16 fix: invert WASD controls in Python and fix Teensy I2C freezing
    Root cause: The Python controller was sending the logical Y-axis values rather than mapping them to the physical robot orientation, making W walk backward and S walk forward. Fixed by swapping W/S and A/D.
    Root cause 2: The Teensy was freezing after 10-15 seconds because of a recent commit that enabled slave_active=1 (for USS sensors). The Teensy I2C Wire library's requestFrom() method defaults to an infinite timeout. If the Slave Nano (USS) glitches, disconnects, or electrical noise affects the I2C bus, Wire.requestFrom blocks forever, completely freezing the Teensy's main loop and stopping it from reading the NRF radio (causi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
    [Nova-SM3_teensyNRF-v5.2b_mp3_pro.ino, nova_controller.py]
2026-08-16 Fix catastrophic memory corruption caused by NRF24L01 dynamic payload overflow; implement hardware auto-recovery for NRF brownouts
    [Nova-SM3_teensyNRF-v5.2b_mp3_pro.ino]
2026-08-16 Rewrite Python controller with thread-safe key handling; fix NRF recovery loop; add debug logging
    - Python: Replace timer-based key debounce with lock-protected key state
    managed entirely in the transmit thread (eliminates IDLE flicker between
    every key press that was causing mode toggle failures and walk cancellation)
    - Python: One-shot commands (mode select, start/stop) sent for 3 consecutive
    packets via queue to guarantee Teensy receives them
    - Teensy: Fix NRF auto-recovery lastNRFUpdate from millis()-1000 to millis()
    which was causing immediate re-trigger of timeout failsafe (startup trot bug)
    - Teensy: Enable debug1 and add [NRF_RX] logging for non-idle packets
    [Nova-SM3_teensyNRF-v5.2b_mp3_pro.ino, nova_controller.py]
2026-08-30 fix: implement stable 1-leg wave creep gait for forward and backward walking
    [Nova-SM3_teensyNRF-v5.2b_mp3_pro.ino, NovaServos.h, nova_controller.py]
2026-08-30 revert: restore original Nova-SM3 step_forward and step_backward implementation
    [Nova-SM3_teensyNRF-v5.2b_mp3_pro.ino]
2026-09-12 fix: restore authentic calibrated servo homes and staged boot homing sequence
    [Nova-SM3_teensyNRF-v5.2b_mp3_pro.ino, NovaServos.h]
2026-09-12 fix: update servoHome calibration values and sync all firmware files (AsyncServo, NovaServos, ino)
    [AsyncServo.h, Nova-SM3_teensyNRF-v5.2b_mp3_pro.ino, NovaServos.h]
2026-09-12 fix: apply final squat calibration values across all project files
    [AsyncServo.h, Nova-SM3_teensyNRF-v5.2b_mp3_pro.ino, NovaServos.h]
2026-09-12 fix: resolve slow walking gait by fixing inverted stride mapping, eliminating ghost potentiometer override, and adding dynamic speed control
    [Nova-SM3_teensyNRF-v5.2b_mp3_pro.ino, nova_controller.py]
2026-09-12 fix: implement symmetrical diagonal pair handshake in walking gaits to resolve front leg asymmetry and tipping
    [SM3_CalibrationTool.stl, SM3_Cover_BottomFront.stl, SM3_Cover_BottomHatch.stl, SM3_Cover_BottomRear.stl, SM3_Cover_HeadPanel.stl, SM3_Cover_LeftFemur.stl, SM3_Cover_RearPanelBtnHolder_6x6LongBtn.stl, SM3_Cover_RearPanel_2Piece_Base.stl]
2026-09-12 fix: level front-right tilt and harmonize rear leg stride in walking gait
    [AsyncServo.h, Nova-SM3_teensyNRF-v5.2b_mp3_pro.ino, NovaServos.h]
2026-09-12 fix: confirmed good forward walk; fix backward walk kinematics to propel robot backward
    [AsyncServo.h, Nova-SM3_teensyNRF-v5.2b_mp3_pro.ino]
2026-09-12 fix: resolve backward walk front leg collapse with stable cantilevered ground-drive kinematics
    [AsyncServo.h, Nova-SM3_teensyNRF-v5.2b_mp3_pro.ino]
2026-09-12 fix: implement true time-reversed forward gait for backward walk with full lift and power
    [Nova-SM3_teensyNRF-v5.2b_mp3_pro.ino]
2026-09-12 fix: resolve rfturn variable typo and unused s4f in step_backward
    [Nova-SM3_teensyNRF-v5.2b_mp3_pro.ino]
2026-09-12 fix: confirmed good backward walk; implement true diagonal-trot turn-in-place gait for 'a' (left) and 'd' (right)
    [AsyncServo.h, Nova-SM3_teensyNRF-v5.2b_mp3_pro.ino]
2026-09-13 fix: resolve Arduino IDE prototype error by adding forward declaration for step_left_right
    [Nova-SM3_teensyNRF-v5.2b_mp3_pro.ino]
2026-09-13 fix: apply updated servoHome calibration values and document turn-in-place test status
    - Updated servoHome calibration across all firmware and calibration files:
    * RF: RFC=390, RFF=290 (was 280), RFT=580 (was 560)
    * LF: LFC=390, LFF=510, LFT=250
    * RR: RRC=420, RRF=210 (was 225), RRT=560 (was 550)
    * LR: LRC=400, LRF=540, LRT=250
    - Turn-in-place test observations (semi-success benchmark):
    * Right turn ('d'): confirmed good, smooth rotation.
    * Left turn ('a'): robot uses right front (RF) leg as a pivot; RF leg gets pushed all the way back under robot weight, placing strain on the servo and causing the robot to lean forward onto that leg. Overall turning is also somewhat slow.
    * S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
    [AsyncServo.h, Nova-SM3_teensyNRF-v5.2b_mp3_pro.ino, NovaServos.h]
2026-09-13 fix(mpu): restore MPU-6050 stabilization, fix init sleep bug, and connect to Python controller
    [Nova-SM3_teensyNRF-v5.2b_mp3_pro.ino, nova_controller.py]
2026-09-14 fix: implement fast coax-driven turn-in-place gait and sequential 1-leg carpet relief homing
    [Nova-SM3_teensyNRF-v5.2b_mp3_pro.ino]
2026-09-20 fix: equalize backward walk RR stride/tilt, prevent MPU auto-enabling, and enhance 1-by-1 homing lift
    - Backward Walk (step_backward):
    * Harmonized Right Rear (RR) reach and ground drive: increased s2f_rr (1.2 -> 1.5) and s3f_rr (1.9 -> 2.5) to match Left Rear (LR), eliminating the previous stroke deficit that caused the robot to steer rightward during backward walk.
    * Reinforced RR stance extension: added s4t_rr = s3t * 0.85 (compared to s4t = s3t * 0.7) during the push phase to firmly support the body and eliminate sag/tilt into the back-right leg.
    - MPU Auto-Enabling Fix:
    * Removed automatic 'mpu_active = 1' triggers from set_stay(), march-stop, follow-stop, forward/backward stop,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
    [Nova-SM3_teensyNRF-v5.2b_mp3_pro.ino]
2026-09-20 fix: prevent tipping during homing with ground pre-centering and fast low-lift carpet tap
    - Ground Pre-Centering: Added Phase 0 in fast_home_carpet() to gently command all 4 legs to servoHome while all 4 feet remain on the ground (120ms delay). This centers the robot's mass and levels the body before any individual leg moves.
    - Anti-Tipping Fast Carpet Tap:
    * Reduced lift height to crisp unweighting levels: lift_t = 35 (~8mm) and lift_f = 10, preventing the corner from dropping or losing support.
    * Accelerated leg tap timing: 35ms lift -> 45ms mid-air coax snap -> 40ms plant down (~120ms total per leg).
    * Fast leg transitions allow body inertia and the 3-leg ground base to completely e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
    [Nova-SM3_teensyNRF-v5.2b_mp3_pro.ino]
2026-09-20 fix(gait): redesign step_backward kinematics to eliminate rear-leg over-lift, cycle accumulation, and tip-over
    - Root Cause 1: Cycle-Accumulation Stranding (The 1-2 Second Bug):
    * In the previous implementation, Step 3 (ground stance push) commanded the femurs forward to 'gaitHome + s3f' / 'gaitHome - s3f_lr' and left them stranded there when resetting servoSequence.
    * On Cycle 2 (1-2 seconds in), Step 0 commanded tibia lift while the LR femur was still stuck forward at 465 (instead of Home at 540). This caused the LR leg to jackknife high into the torso/chest, removing rear-left ground support and causing the robot to tip over onto its back-right side.
    * Resolved: In Step 3, all 4 fem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
    [Nova-SM3_teensyNRF-v5.2b_mp3_pro.ino]
2026-09-21 fix(poses): apply user-calibrated sit, lay down, and crouch servo positions
    - Updated set_sit() with exact user-measured angles:
    * Coxas: RFC=390, LFC=390, RRC=420, LRC=400 (neutral)
    * Femurs: RFF=290, LFF=510, RRF=210, LRF=540 (neutral)
    * Front Tibias (upright extension): RFT=480, LFT=340
    * Rear Tibias (seated fold): RRT=630, LRT=160
    - Updated set_lay() and set_crouch() with exact user-measured angles:
    * Coxas: RFC=390, LFC=390, RRC=420, LRC=400 (neutral)
    * Femurs: RFF=290, LFF=510, RRF=210, LRF=540 (neutral)
    * Front Tibias (belly fold): RFT=680, LFT=130
    * Rear Tibias (belly fold): RRT=690, LRT=130
    - Aliased set_crouch() to set_lay() so both Remote Button 3/4, Pot 2 (p2==4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
    [Nova-SM3_teensyNRF-v5.2b_mp3_pro.ino]
2026-09-21 fix(gait): redesign step_backward with cantilevered front support, low tibia lift, and equalized forward stance propulsion
    - Root Cause Analysis:
    * In the previous iteration, front femurs swung backward in the air (RFF: 230, LFF: 570), placing the front feet behind the shoulder line underneath the torso.
    * Because Nova SM3 has a forward-biased center of gravity (heavy battery, Teensy, wiring, OLED/head), placing front feet rearward eliminated the cantilever support base; when the opposing diagonal pair lifted, the torso immediately pitched nose-down and collapsed onto the front-left leg.
    * Over-lifting rear tibias (75 units) had previously caused the pelvis to twist and roll onto the b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
    [Nova-SM3_teensyNRF-v5.2b_mp3_pro.ino]
2026-09-26 docs: transform root README.md into build log and engineering blog
    - Documented complete build journey of the NovaSM3 quadruped robot dog by Sreyas.
    - Added comprehensive sections covering:
    * Motivation and SpotMicro/NovaSM3 background.
    * Complete bill of materials and hardware parts list.
    * Wiring challenges, wire gauge selections (18 AWG power vs 22 AWG signal), and dual PCA9685 power inputs.
    * Reverse polarity buck converter troubleshooting and flux burn-off incidents.
    * Power-on sequencing to prevent erratic servo spins and glued servo horn lessons.
    * Teensy 4.0/4.1 USB Serial Monitor debugging and watchdog timer crash loop resolution.
    * Arduino Nano Old Bootloader flashing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
2026-09-26 docs: embed build photos, wiring diagrams, and joint test GIF across blog
